felixzero/escrocs/README.md

# Repository of the E.S.C.Ro.C.S. team at the French robotics cup

We have participated in 2020, 2021 and 2022.

You can find here our codes, PCB and mechanical designs. We use Platform.io and VSCodium for coding, KiCAD for PCB CAD and either FreeCAD or TinkerCAD for mechanical design.
