felixzero/escrocs/CAD/electrical/accessory_board/README.md

# Accessory board

This PCB is a fairly large PCB meant for driving various types of actuators:
- up to 16 analog servos (typically MG-996 servos)
- up to 2 5V or 12V unipolar steppers
- up to 4 pumps or other 12V DC devices (2 x 500mA + 2 x 1A)

It does not require any firmware as it make use of NXP's I2C controller chips.
