felixzero/escrocs/CAD/electrical/main_board_v2/README.md

# Main board

This is the brain of our robots. It is based on a single ESP32 chip executing the strategy and interfacing with other boards.
