felixzero/escrocs/CAD/mechanical/servo_gears_info.md

# Dimensions d'engrenage

SG-90 : N=20 m=0.23mm
SG-90 : N=20 m=0.24mm (la version achetée sur eBay)

# Gros noir

N=25 m=0.23
