felixzero/escrocs/misc/ArUco/ArUcos_2022.docx

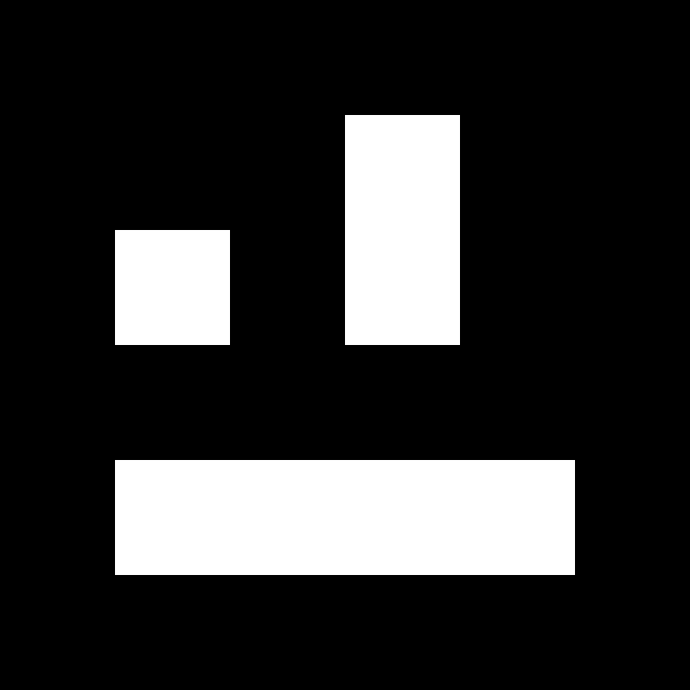
[picture p1: figure]

13 (bleu)

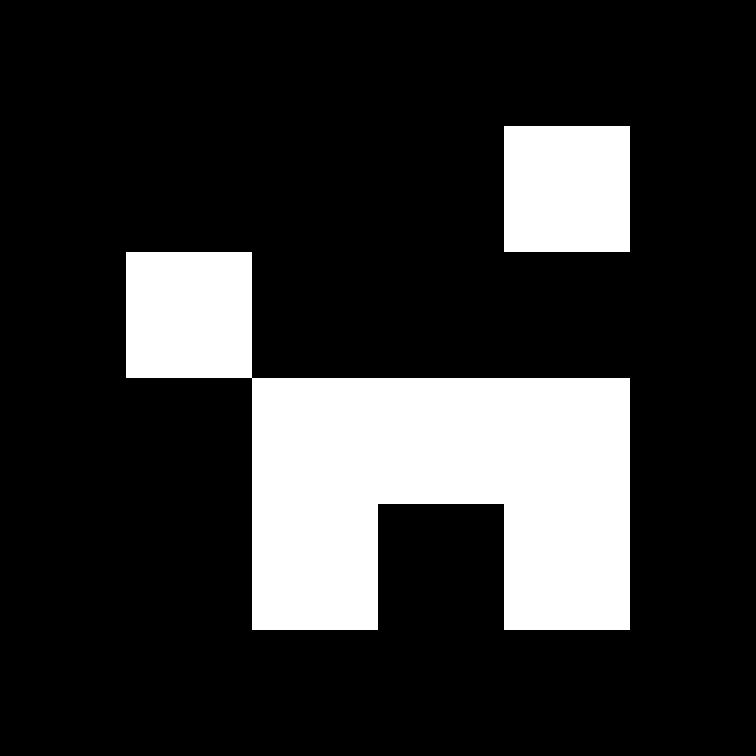
[picture p2: figure]

36 (vert)

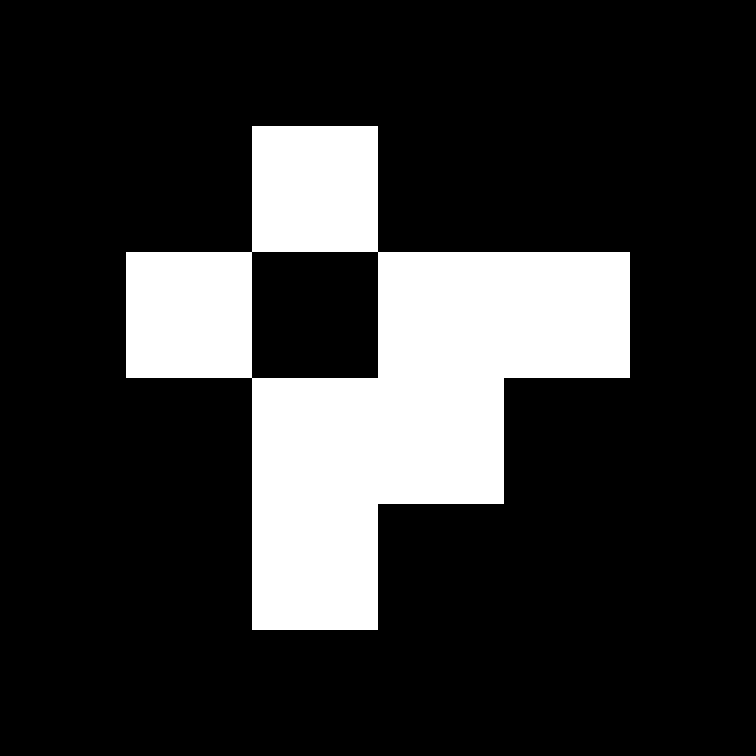
[picture p3: figure]

47 (rouge)
