felixzero/escrocs/misc/Poster 2022.pdf

Les robots des E.S.C.Ro.C.S.

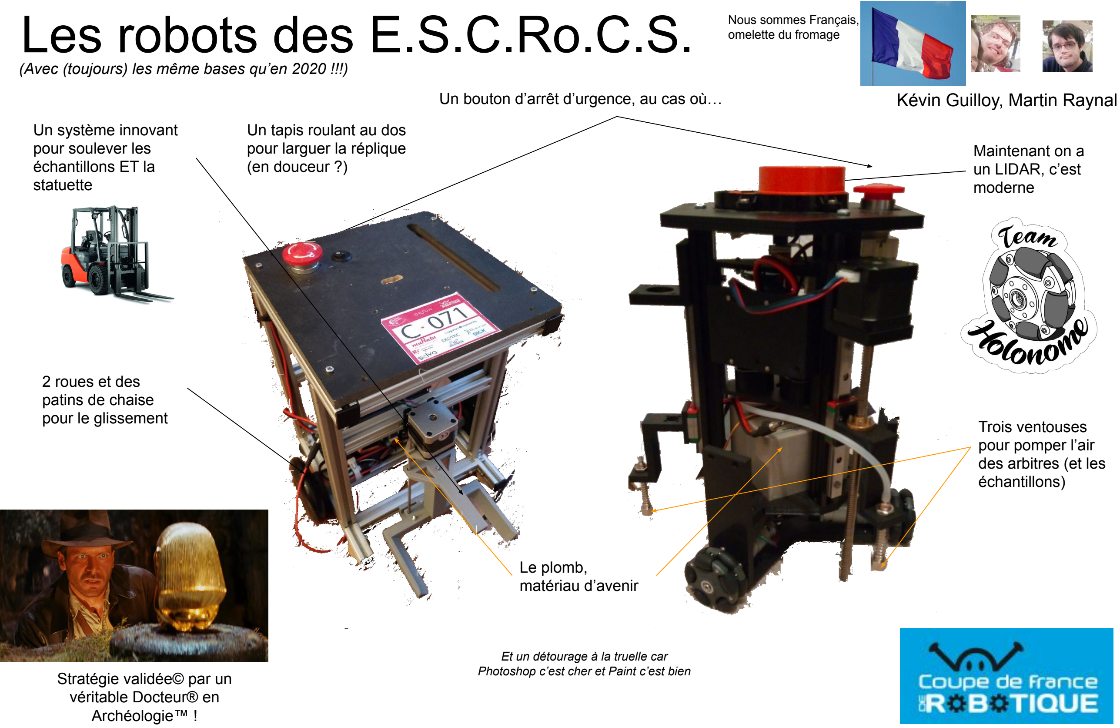
[picture p4: page 1]

2 roues et des
patins de chaise
pour le glissement

Le plomb,
matériau d’avenir

Un système innovant
pour soulever les
échantillons ET la
statuette

Un bouton d’arrêt d’urgence, au cas où…

Maintenant on a
un LIDAR, c’est
moderne

Nous sommes Français,
omelette du fromage

(Avec (toujours) les même bases qu’en 2020 !!!)

Kévin Guilloy, Martin Raynal

Stratégie validée© par un
véritable Docteur® en
Archéologie™ !

Trois ventouses
pour pomper l’air
des arbitres (et les
échantillons)

Un tapis roulant au dos
pour larguer la réplique
(en douceur ?)

Et un détourage à la truelle car Photoshop c’est cher et Paint c’est bien
