felixzero/escrocs/misc/remote_control/table.png

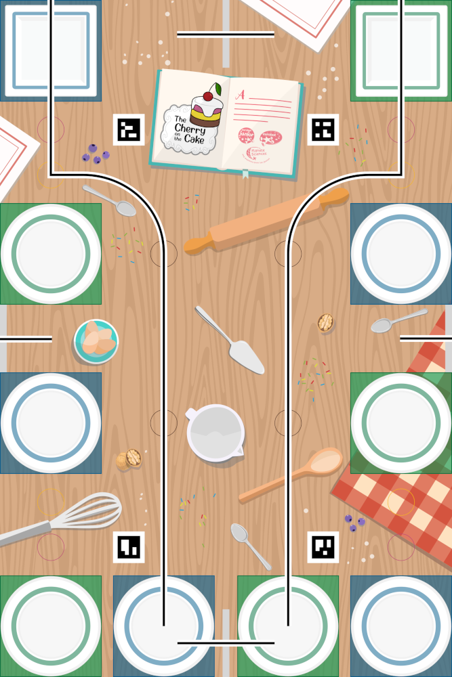
misc/remote_control/table.png
