felixzero/escrocs/CAD/electrical/motor_board_v3/bom.xlsx

Comment | Designator | Footprint | LCSC Part Number
100n capacitor | C1,C2,C4,C6,C8,C9,C10,C14,C15,C16,C20,C21,C22 | Capacitor_SMD:C_0603_1608Metric | C14663
10n 50V capacitor | C7,C13,C19 | Capacitor_SMD:C_0603_1608Metric | C57112
22p capacitor | C11,C17 | Capacitor_SMD:C_0603_1608Metric | C1653
470n capacitor | C12,C18,C24 | Capacitor_SMD:C_0603_1608Metric | C1623
SS54 | D5 | Diode_SMD:D_SMA | C22452
SMF30A | D6,D7 | Diode_SMD:D_SMF | C2990493
PSM712 | D9 | Package_TO_SOT_SMD:SOT-23 | C32677
2920L700SLPR | F1 | Fuse:Fuse_2920_7451Metric | C207093
BLM31PG330SZ1L | FB1 | Inductor_SMD:L_1206_3216Metric | C710521
GZ1608D601TF | FB2 | Inductor_SMD:L_0603_1608Metric | C1002
SI2301CDS-T1-GE3 | Q1 | Package_TO_SOT_SMD:SOT-23 | C10487
300 resistor | R1,R4,R6,R7 | Resistor_SMD:R_1206_3216Metric | C17887
220 resistor | R2,R3 | Resistor_SMD:R_0603_1608Metric | C22962
120 resistor | R5 | Resistor_SMD:R_0603_1608Metric | C22787
1,5M resistor | R9,R12,R15 | Resistor_SMD:R_0603_1608Metric | C4172
0,1 ohm resistor | R10,R11,R13,R14,R16,R17 | Resistor_SMD:R_1206_3216Metric | C25334
10k resistor | R18,R19 | Resistor_SMD:R_0603_1608Metric | C25804
Atmega328PB | U1 | Package_QFP:TQFP-32_7x7mm_P0.8mm | C132230
SN75176BDR | U2 | Package_SO:SOIC-8_3.9x4.9mm_P1.27mm | C7063
DRV8825 | U3,U4,U5 | Package_SO:HTSSOP-28-1EP_4.4x9.7mm_P0.65mm_EP2.85x5.4mm | C81582
SRV05-4 | U8,U6 | Package_TO_SOT_SMD:SOT-23-6 | C85364
16MHz crystal | Y1 | Crystal:Crystal_SMD_3225-4Pin_3.2x2.5mm | C13738
