felixzero/escrocs/CAD/electrical/ultrasonic_board/bom.xls

Comment | Designator | Footprint | LCSC Part Number
22pF capacitor | C1,C2 | 0603 | C1653
100nF capacitor | C4 | 0603 | C14663
LED | D1 | 0805 | C2296
10k resistor | R1 | 0603 | C25804
120r resistor | R2 | 0603 | C22787
470r resistor | R3 | 0603 | C23179
ATMegaX X=328,168 or 8 | U1 | TQFP-32 | C16190
8 MHz crystal | Y1 | HC49 | C12674
