felixzero/escrocs/CAD/electrical/stepper_board/fabrication_files/bom.xlsx

Comment | Designator | Footprint | LCSC Part Number
100n | C16,C19 | Capacitor_SMD:C_0805_2012Metric | C28233
22p | C20,C24 | Capacitor_SMD:C_0603_1608Metric | C1653
100n | C1,C7,C13,C15,C17,C25 | Capacitor_SMD:C_0603_1608Metric | C14663
1n | C2,C3,C8,C9,C26,C27 | Capacitor_SMD:C_0603_1608Metric | C1588
220n | C4,C5,C6,C10,C11,C12,C28,C29,C30 | Capacitor_SMD:C_0603_1608Metric | C21120
Status LED | D1,D2,D3 | LED_SMD:LED_0603_1608Metric | C72038
300o | R25,R26,R27 | Resistor_SMD:R_1206_3216Metric | C17887
10k | R2,R3,R6,R10,R11,R14,R28,R30,R31,R34 | Resistor_SMD:R_0603_1608Metric | C25804
47k | R1,R4,R9,R12,R29,R32 | Resistor_SMD:R_0603_1608Metric | C25819
33k | R5,R13,R33 | Resistor_SMD:R_0603_1608Metric | C4216
0.1 | R7,R8,R15,R16,R35,R36 | Resistor_SMD:R_1206_3216Metric | C25334
ATmega168PA-AU | U1 | Package_QFP:TQFP-32_7x7mm_P0.8mm | C8728
DRV8811 | U2,U4,U5 | Package_SO:HTSSOP-28-1EP_4.4x9.7mm_P0.65mm_EP2.85x5.4mm_ThermalVias | C133174
ULN2003 | U3 | Package_SO:SO-16_3.9x9.9mm_P1.27mm | C7512
Crystal | Y1 | Crystal:Crystal_SMD_HC49-SD | C12674
