felixzero/escrocs/CAD/mechanical/2022_robot1_square/batterie_elec/batterie_elec.FCStd

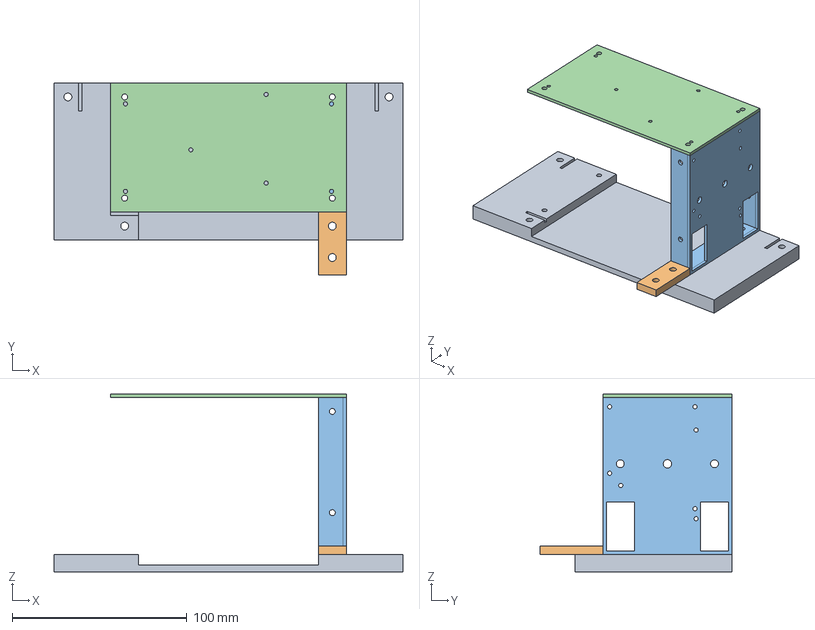
[picture p6: CAD file, 2021-10-28]
CAD/mechanical/2022_robot1_square/batterie_elec/batterie_elec.FCStd
200.0 x 110.0 x 102.0 mm
Fond
PatteFixation
PlaqueLaterale
PlaqueDessus
