felixzero/escrocs/CAD/mechanical/2022_robot1_square/mat_balise_robot_carre/mat_balise_robot_carre.FCStd

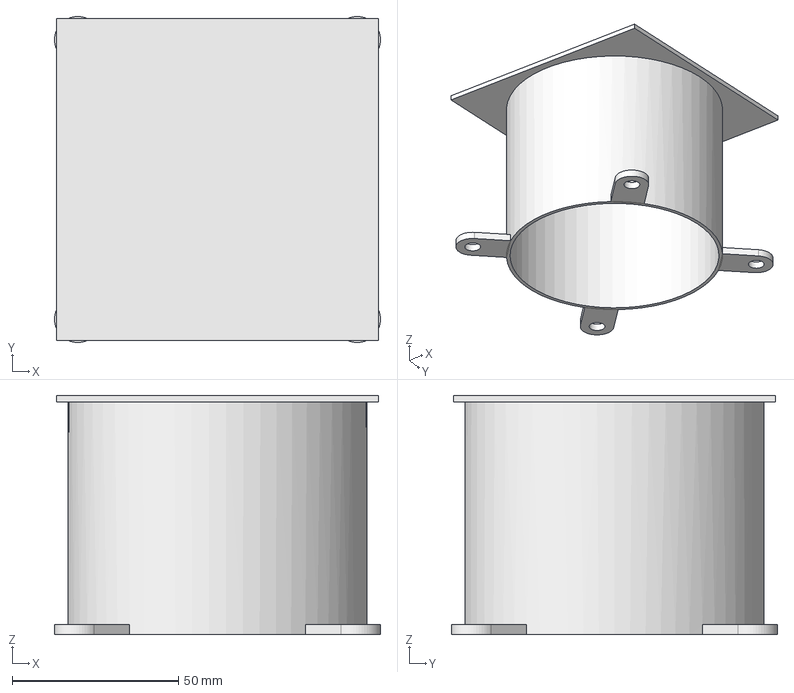
[picture p7: CAD file, 2022-05-18]
CAD/mechanical/2022_robot1_square/mat_balise_robot_carre/mat_balise_robot_carre.FCStd
98.1 x 98.1 x 72.0 mm
