felixzero/escrocs/CAD/mechanical/2022_robot1_square/patin/patin_thick.FCStd

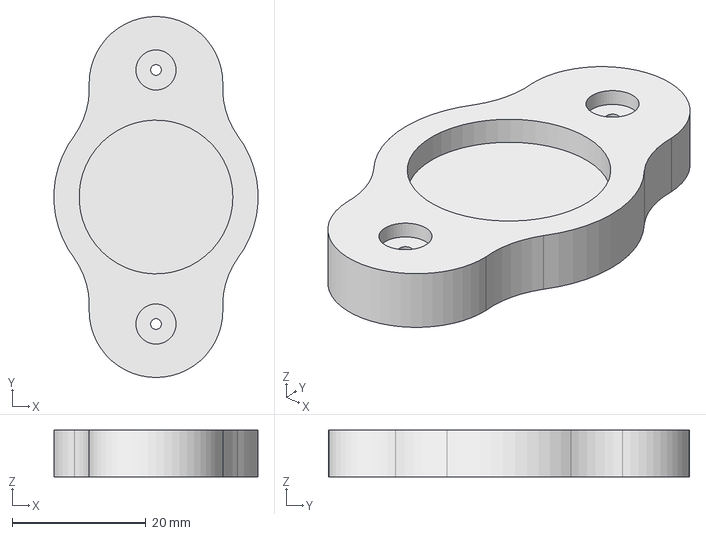
[picture p8: CAD file, 2021-07-31]
CAD/mechanical/2022_robot1_square/patin/patin_thick.FCStd
30.5 x 54.0 x 7.00 mm
