felixzero/escrocs/CAD/mechanical/2022_robot1_square/pince-statuette/Robot_2022_support_broche.stl

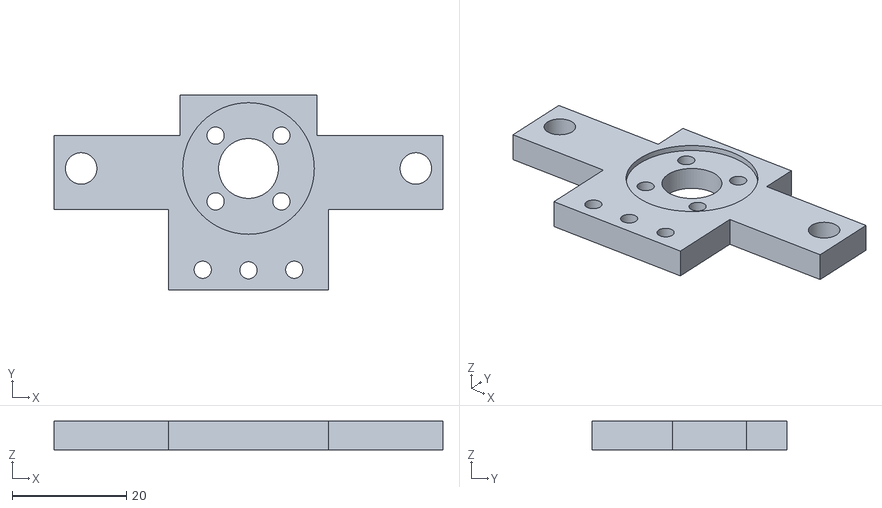
[picture p9: CAD file, 2022-05-23]
CAD/mechanical/2022_robot1_square/pince-statuette/Robot_2022_support_broche.stl
68.0 x 34.0 x 5.00
