felixzero/escrocs/CAD/mechanical/2022_robot1_square/score-plate/score-plate.FCStd

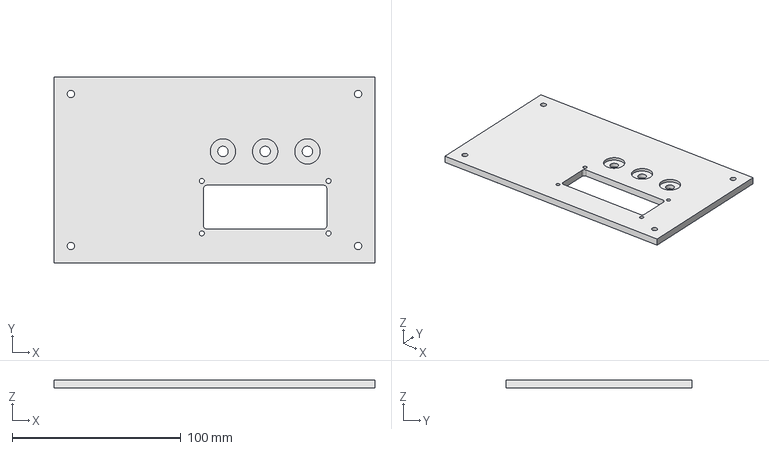
[picture p10: CAD file, 2020-11-22]
CAD/mechanical/2022_robot1_square/score-plate/score-plate.FCStd
190.0 x 110.0 x 5.00 mm
