felixzero/escrocs/CAD/mechanical/2022_robot1_square/statuette/Statuette_EUROBOT2022.stl

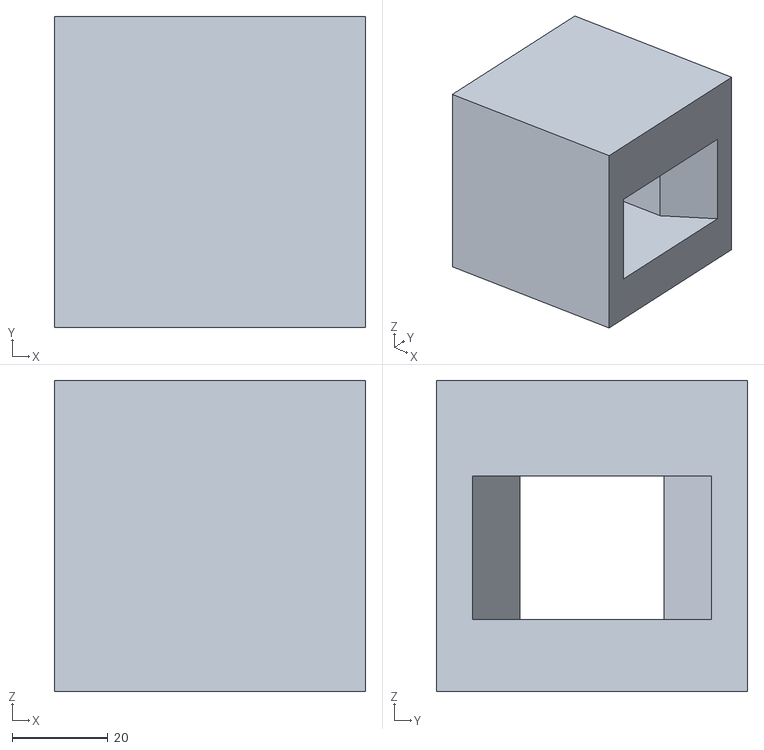
[picture p11: CAD file, 2022-05-23]
CAD/mechanical/2022_robot1_square/statuette/Statuette_EUROBOT2022.stl
65.0 x 65.0 x 65.0
