felixzero/escrocs/CAD/mechanical/2022_robot1_square/support-moteur/support-moteur-long.FCStd

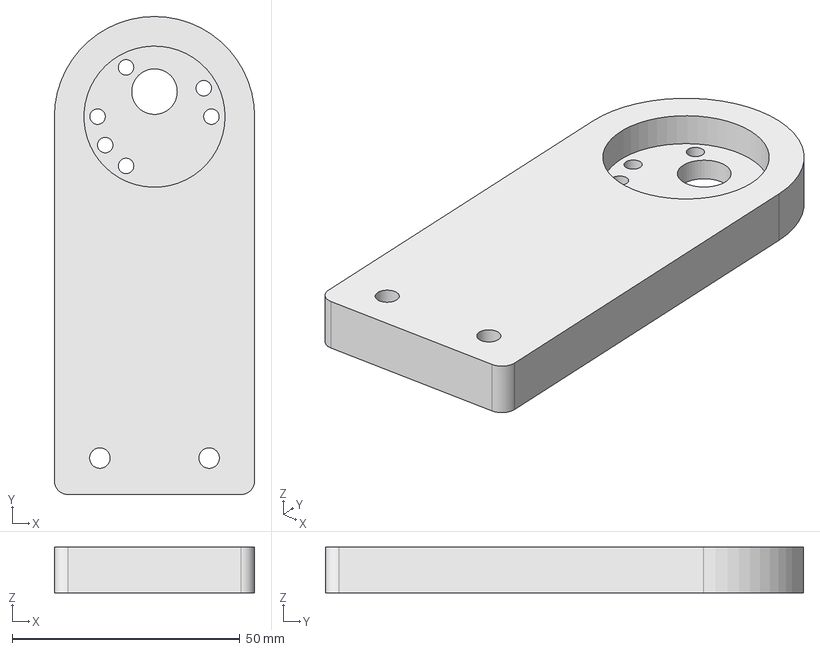
[picture p12: CAD file, 2021-06-20]
CAD/mechanical/2022_robot1_square/support-moteur/support-moteur-long.FCStd
44.0 x 105.0 x 10.0 mm
