felixzero/escrocs/CAD/mechanical/2022_robot1_square/T-joints/T-Slot_H3.stl

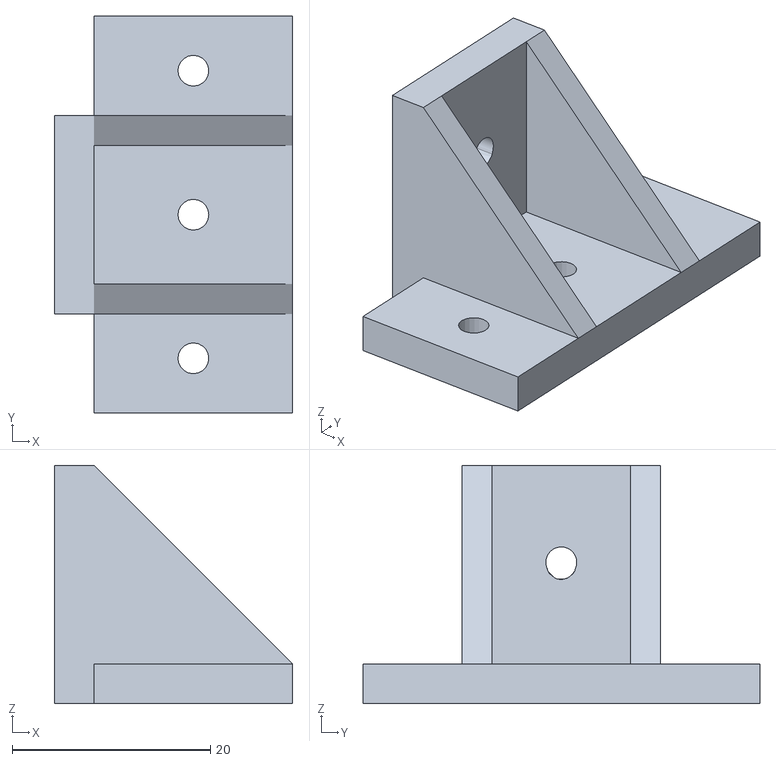
[picture p13: CAD file, 2021-06-06]
CAD/mechanical/2022_robot1_square/T-joints/T-Slot_H3.stl
24.0 x 40.0 x 24.0
