felixzero/escrocs/CAD/mechanical/2022_robot2_triangle/base_roulante/base_roulante_v2.FCStd

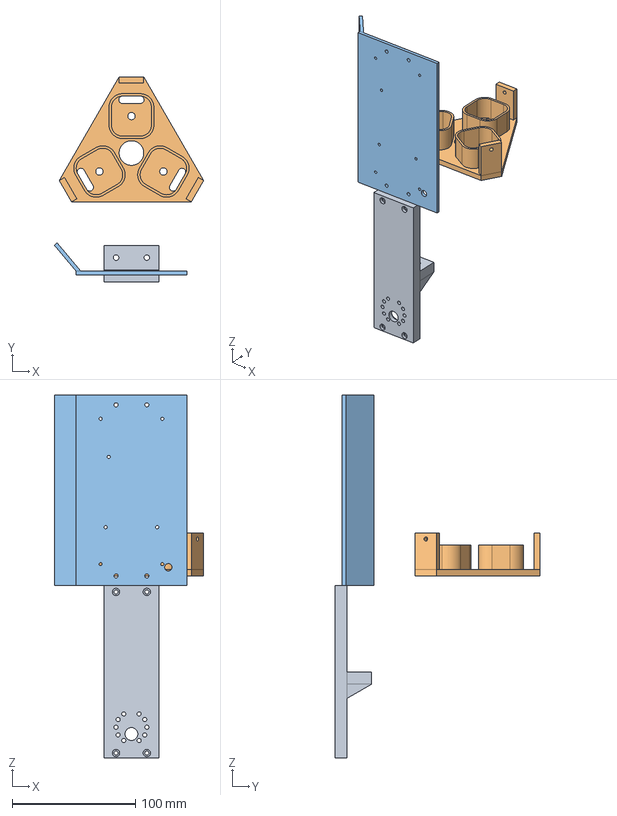
[picture p14: CAD file, 2022-05-18]
CAD/mechanical/2022_robot2_triangle/base_roulante/base_roulante_v2.FCStd
121.4 x 167.0 x 295.0 mm
SupportMoteur
SupportPompe
CoteAutocollant
