felixzero/escrocs/CAD/mechanical/2022_robot2_triangle/rail_pompe/rail_pompe.FCStd

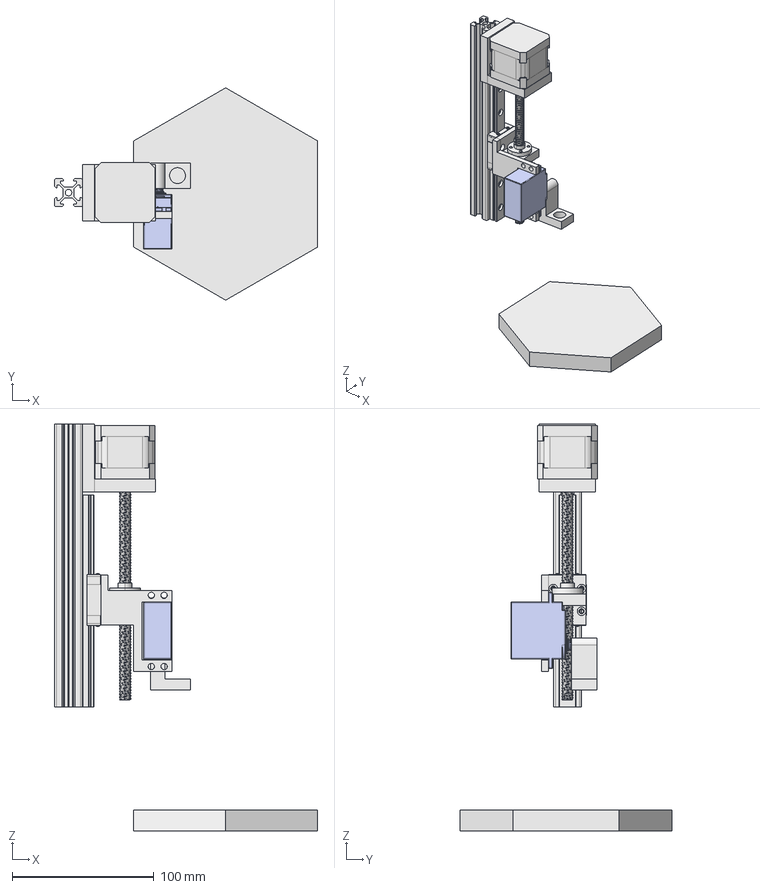
[picture p15: CAD file, 2022-05-09]
CAD/mechanical/2022_robot2_triangle/rail_pompe/rail_pompe.FCStd
186.0 x 150.0 x 287.5 mm
ProfileAlu
RailGlissiere
Echantillon
Stepper001
TravelingNut
SupportStepper
Servo MG996R
SupportGlissiereArticulee
SupportPompeArticulee
