felixzero/escrocs/CAD/mechanical/2022_robot2_triangle/support-mat-balise/support-mat-balise.FCStd

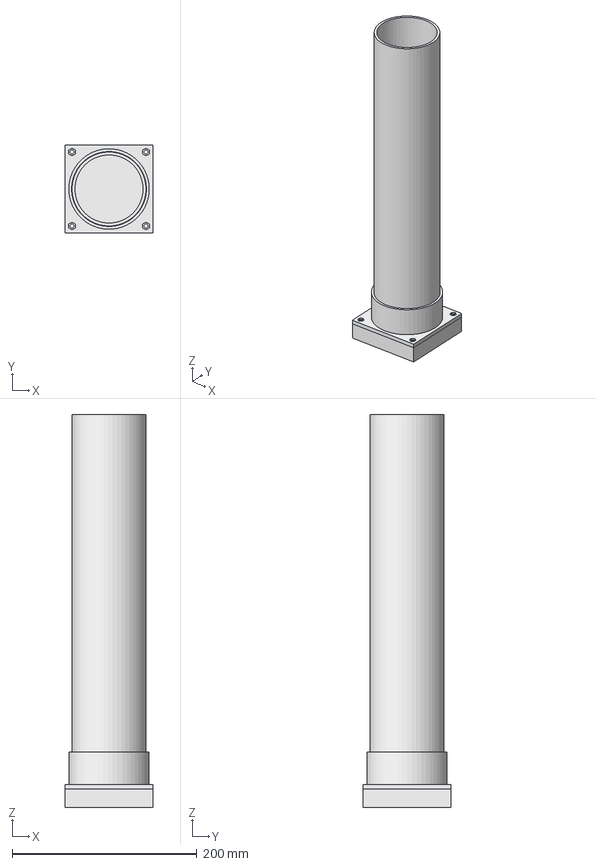
[picture p16: CAD file, 2022-02-14]
CAD/mechanical/2022_robot2_triangle/support-mat-balise/support-mat-balise.FCStd
95.0 x 95.0 x 425.0 mm
Plaque de base
Plaque de support tuyau
Tuyau
