felixzero/escrocs/CAD/mechanical/2024_base_roulante/base_roulante_2024-Pare-choc.amf

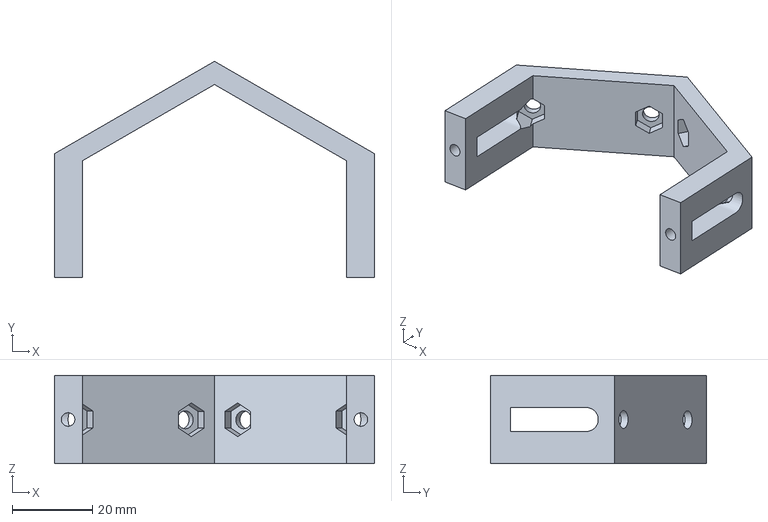
[picture p17: CAD file, 2023-06-20]
CAD/mechanical/2024_base_roulante/base_roulante_2024-Pare-choc.amf
80.0 x 54.1 x 22.0 mm
