felixzero/escrocs/CAD/mechanical/amf/support-us-USRing.amf

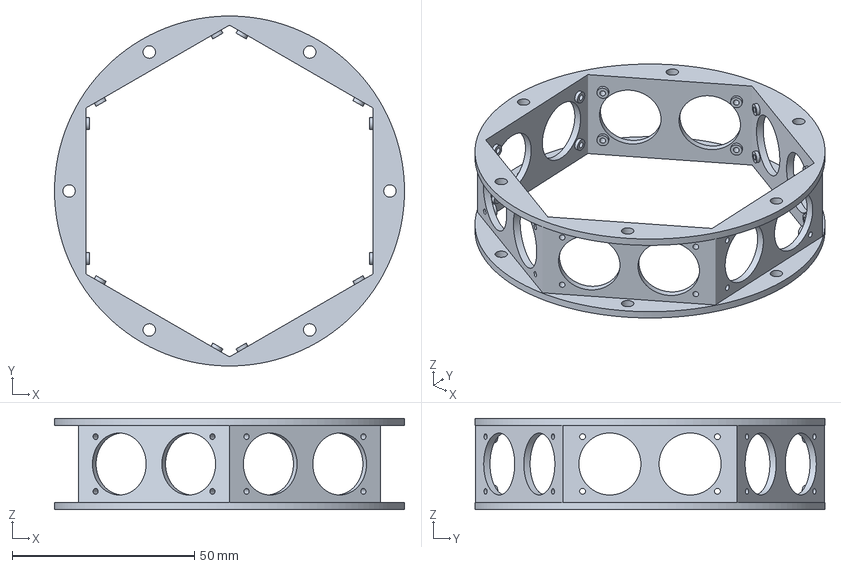
[picture p18: CAD file, 2023-05-22]
CAD/mechanical/amf/support-us-USRing.amf
96.0 x 96.0 x 25.0 mm
