felixzero/escrocs/CAD/mechanical/support-us.FCStd

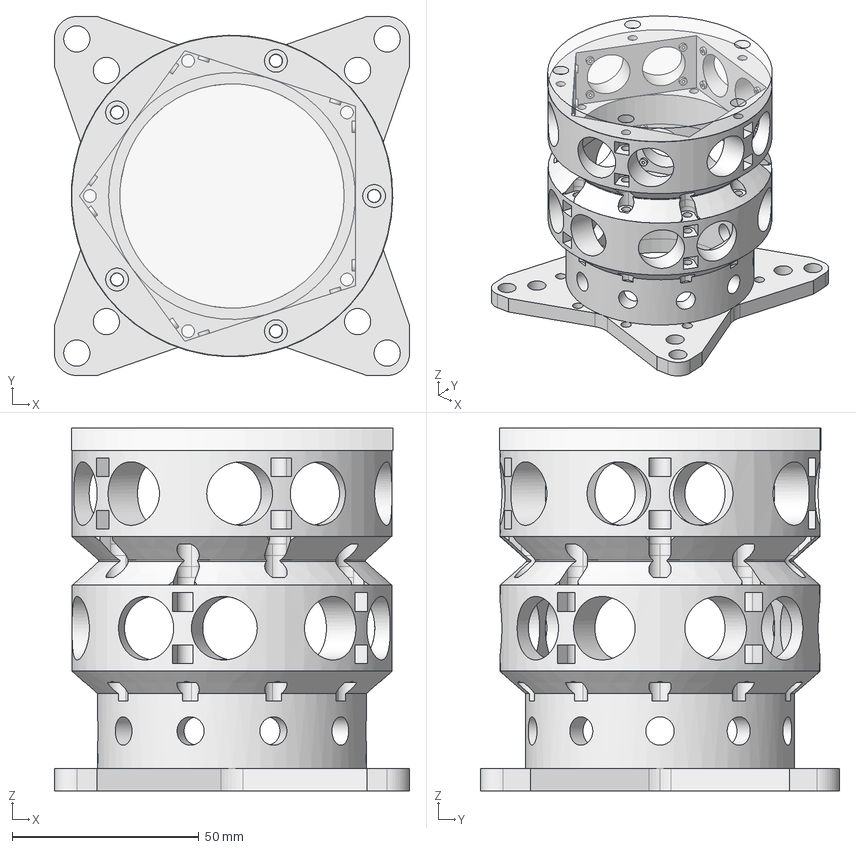
[picture p19: CAD file, 2023-05-22]
CAD/mechanical/support-us.FCStd
95.0 x 96.0 x 97.0 mm
US Ring Pentagon x 2
LED Support Pentagon
Support PCB Pentagon
Toit
