felixzero/escrocs/CAD/mechanical/trigger/trigger-Clef.amf

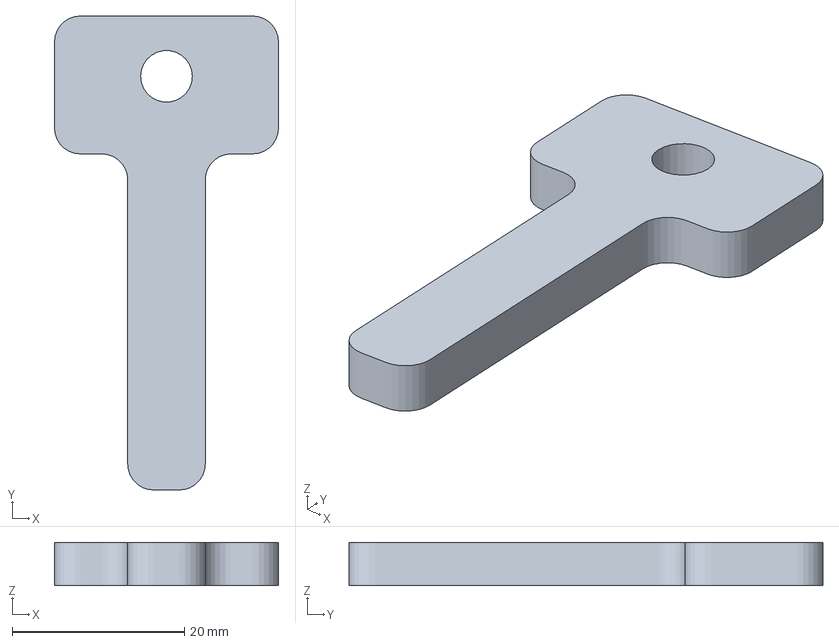
[picture p20: CAD file, 2023-05-22]
CAD/mechanical/trigger/trigger-Clef.amf
26.0 x 55.0 x 5.00 mm
