felixzero/escrocs/CAD/mechanical/2022_robot1_square/patin/patin.FCStd

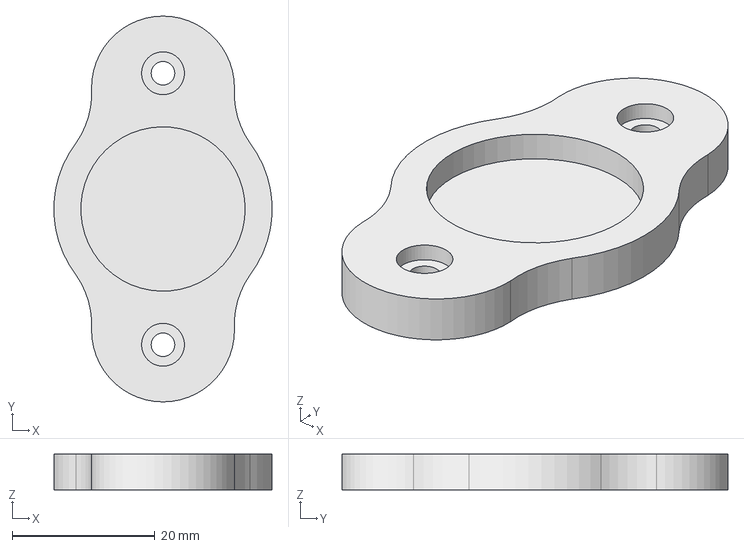
[picture p21: CAD file, 2021-01-08]
CAD/mechanical/2022_robot1_square/patin/patin.FCStd
30.5 x 54.0 x 5.00 mm
