felixzero/escrocs/CAD/mechanical/2022_robot1_square/pince-statuette/Robot_2022_broche-v2.stl

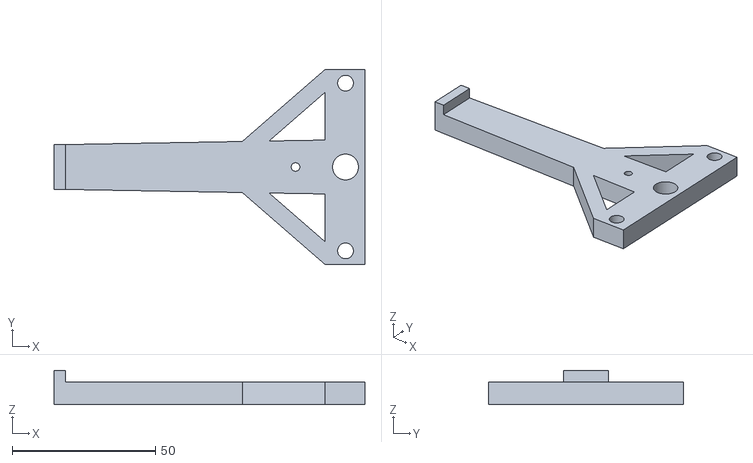
[picture p22: CAD file, 2022-05-23]
CAD/mechanical/2022_robot1_square/pince-statuette/Robot_2022_broche-v2.stl
108.5 x 68.0 x 12.0
