felixzero/escrocs/CAD/mechanical/2022_robot1_square/support-moteur/support-moteur-v2.FCStd

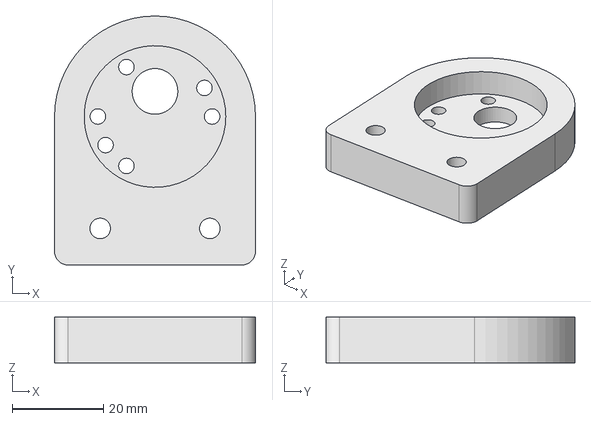
[picture p23: CAD file, 2021-01-08]
CAD/mechanical/2022_robot1_square/support-moteur/support-moteur-v2.FCStd
44.0 x 54.5 x 10.0 mm
