felixzero/escrocs/CAD/mechanical/2022_robot1_square/T-joints/T-Slot_4.stl

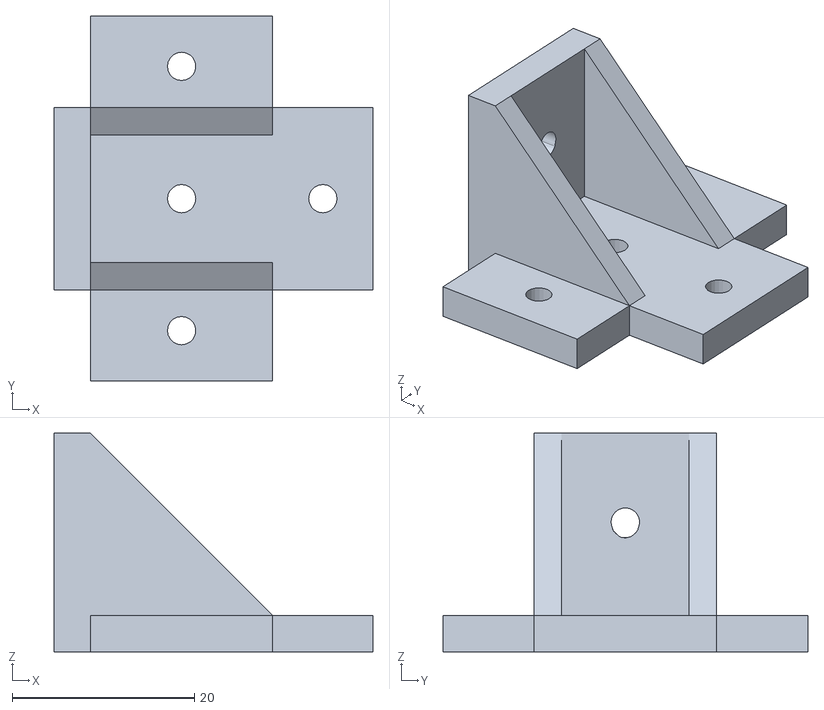
[picture p24: CAD file, 2021-06-06]
CAD/mechanical/2022_robot1_square/T-joints/T-Slot_4.stl
35.0 x 40.0 x 24.0
