felixzero/escrocs/CAD/mechanical/2024_base_roulante/base_roulante_2024-Base.amf

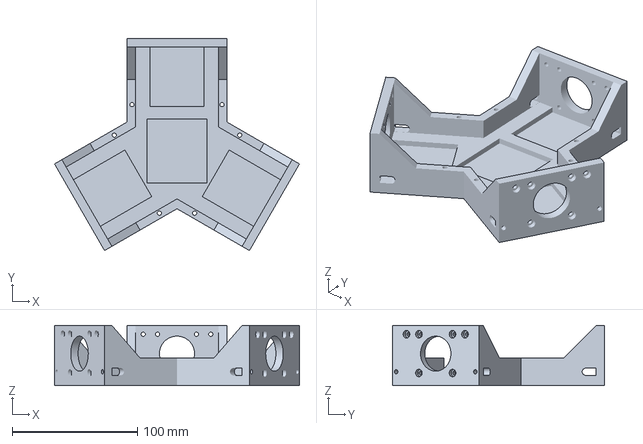
[picture p25: CAD file, 2023-06-20]
CAD/mechanical/2024_base_roulante/base_roulante_2024-Base.amf
195.9 x 169.6 x 48.0 mm
