felixzero/escrocs/CAD/mechanical/amf/support-us-PCBRing.amf

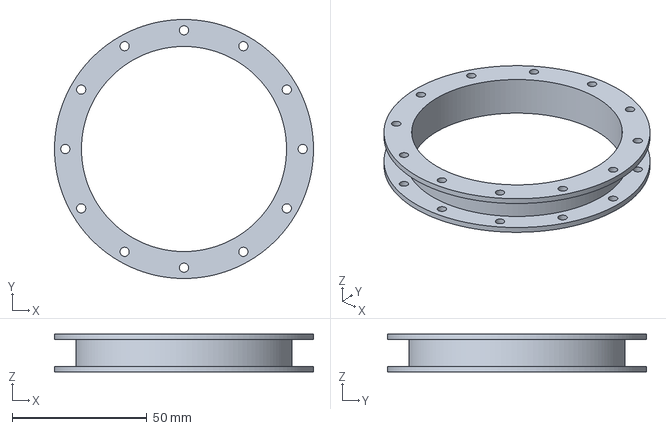
[picture p26: CAD file, 2023-05-22]
CAD/mechanical/amf/support-us-PCBRing.amf
96.0 x 96.0 x 14.0 mm
