felixzero/escrocs/CAD/mechanical/robot_triangle.FCStd

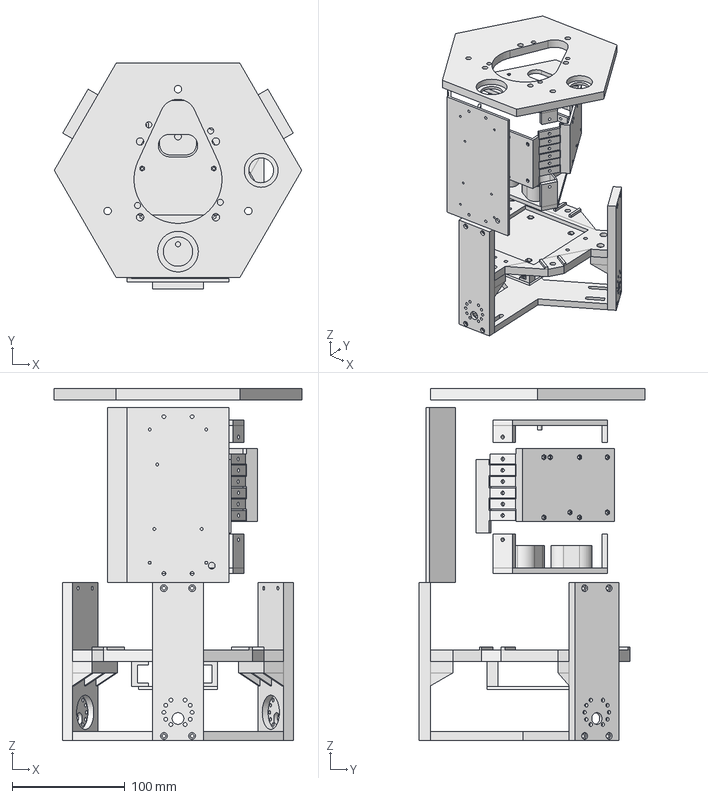
[picture p27: CAD file, 2023-03-11]
CAD/mechanical/robot_triangle.FCStd
219.4 x 200.0 x 312.0 mm
TriangleBatterie
SupportCarteMoteur
EquerreCarteMoteur x 4
SupportMoteur x 3
RenfortBas
SupportPompe
SupportCarteMere x 2
SupportLidar
SupportCarteLidar
CoteAutocollant
