felixzero/escrocs/CAD/mechanical/trigger/trigger.FCStd

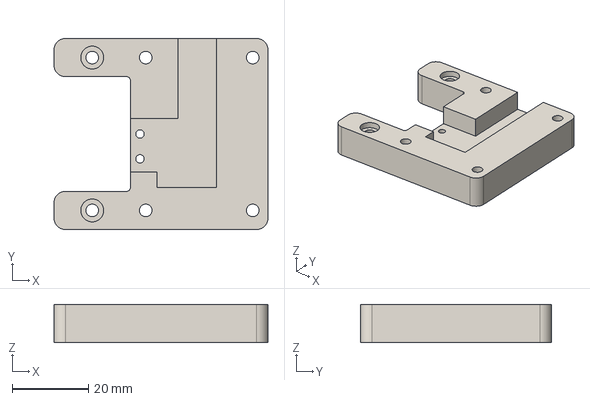
[picture p28: CAD file, 2020-11-17]
CAD/mechanical/trigger/trigger.FCStd
56.0 x 50.0 x 10.0 mm
