felixzero/escrocs/CAD/mechanical/2022_robot1_square/pince-statuette/bras_vitrine.stl

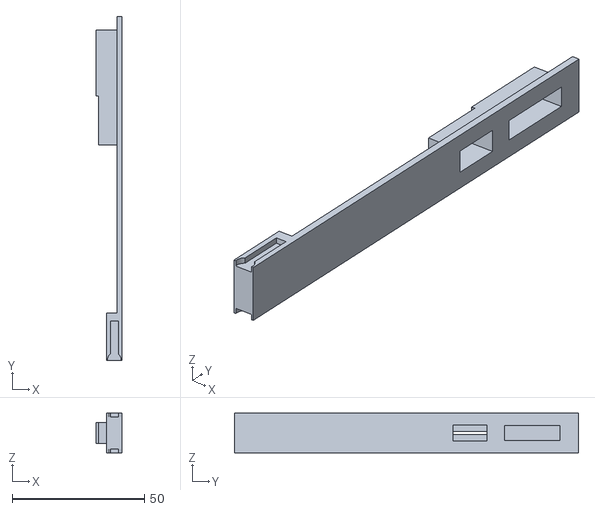
[picture p29: CAD file, 2022-05-23]
CAD/mechanical/2022_robot1_square/pince-statuette/bras_vitrine.stl
10.0 x 130.0 x 15.0
