felixzero/escrocs/CAD/mechanical/2022_robot1_square/T-joints/T-Junction.stl

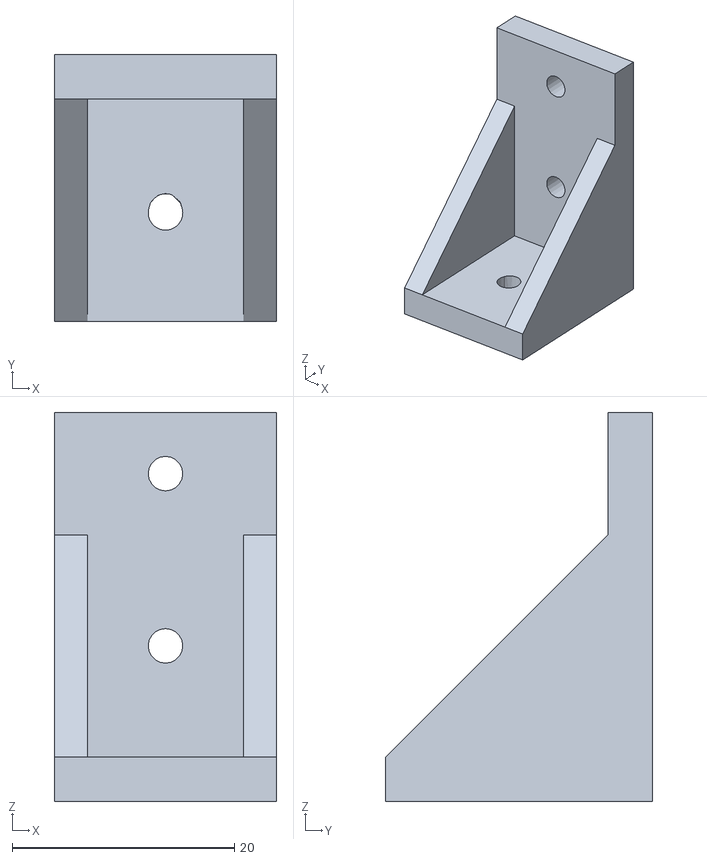
[picture p30: CAD file, 2021-06-06]
CAD/mechanical/2022_robot1_square/T-joints/T-Junction.stl
20.0 x 24.0 x 35.0
