felixzero/escrocs/CAD/mechanical/2024_base_roulante/base_roulante_2024-Carter base roulante.amf

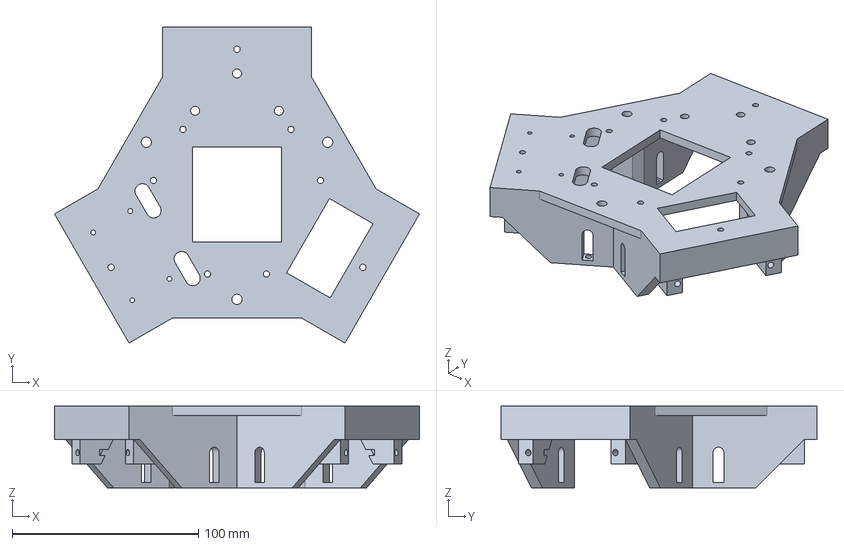
[picture p31: CAD file, 2023-06-20]
CAD/mechanical/2024_base_roulante/base_roulante_2024-Carter base roulante.amf
195.9 x 169.6 x 44.0 mm
