felixzero/escrocs/CAD/mechanical/amf/support-us-Support PCB Pentagon.amf

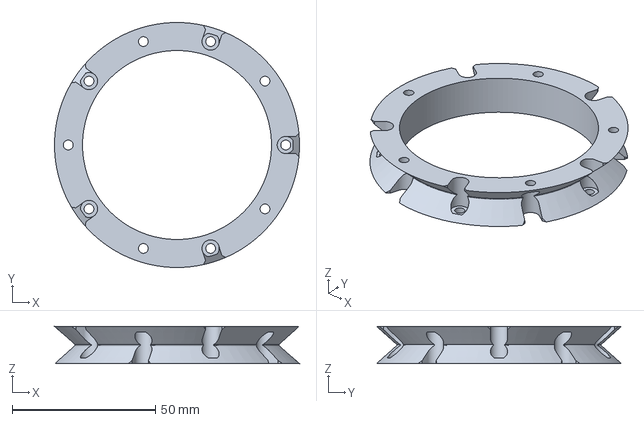
[picture p32: CAD file, 2023-05-22]
CAD/mechanical/amf/support-us-Support PCB Pentagon.amf
85.6 x 85.6 x 13.0 mm
