felixzero/escrocs/CAD/mechanical/2022_robot1_square/pince-statuette/Robot_2022_broche.stl

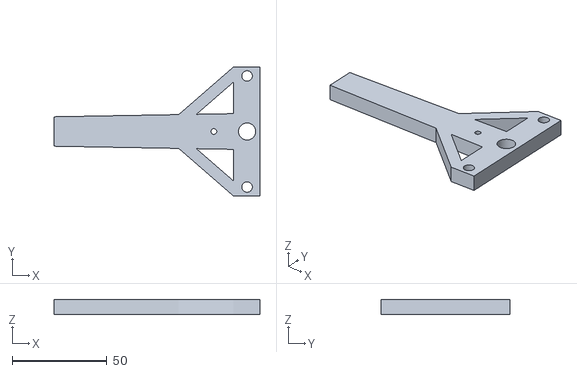
[picture p33: CAD file, 2022-05-23]
CAD/mechanical/2022_robot1_square/pince-statuette/Robot_2022_broche.stl
108.5 x 68.0 x 8.00
