felixzero/escrocs/CAD/mechanical/2022_robot1_square/T-joints/T-SlotAngle-Brackets-M3.stl

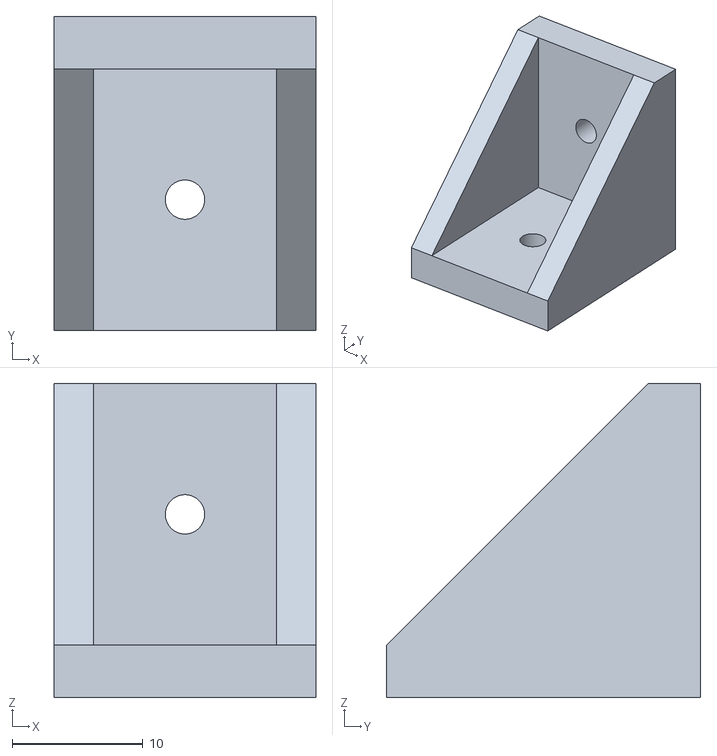
[picture p34: CAD file, 2021-06-06]
CAD/mechanical/2022_robot1_square/T-joints/T-SlotAngle-Brackets-M3.stl
20.0 x 24.0 x 24.0
