felixzero/escrocs/CAD/mechanical/2024_base_roulante/base_roulante_2024-Common.amf

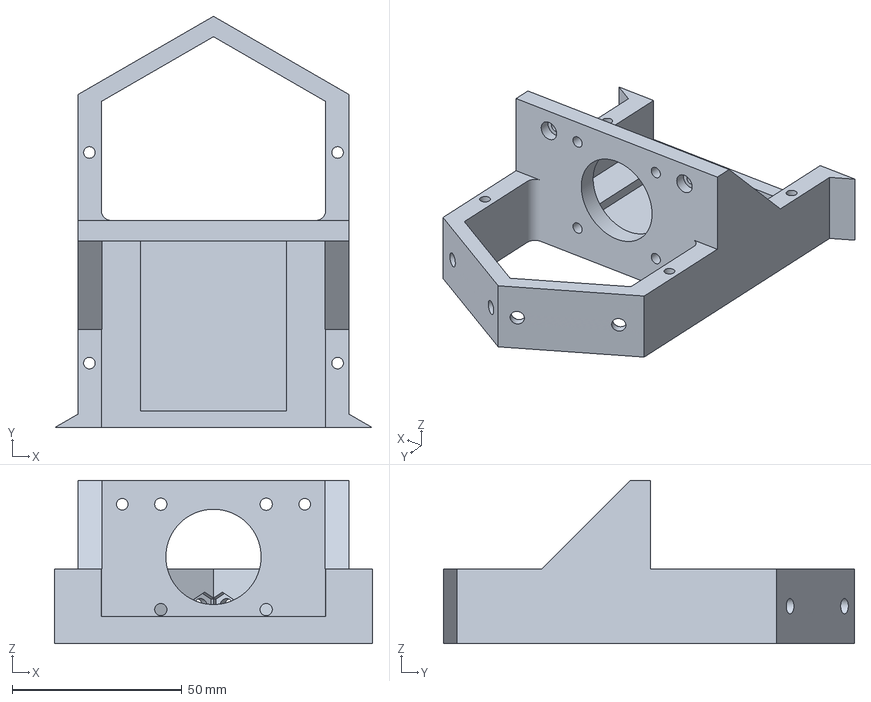
[picture p35: CAD file, 2023-06-20]
CAD/mechanical/2024_base_roulante/base_roulante_2024-Common.amf
93.5 x 121.0 x 48.0 mm
