felixzero/escrocs/CAD/mechanical/amf/support-us-US Ring Pentagon.amf

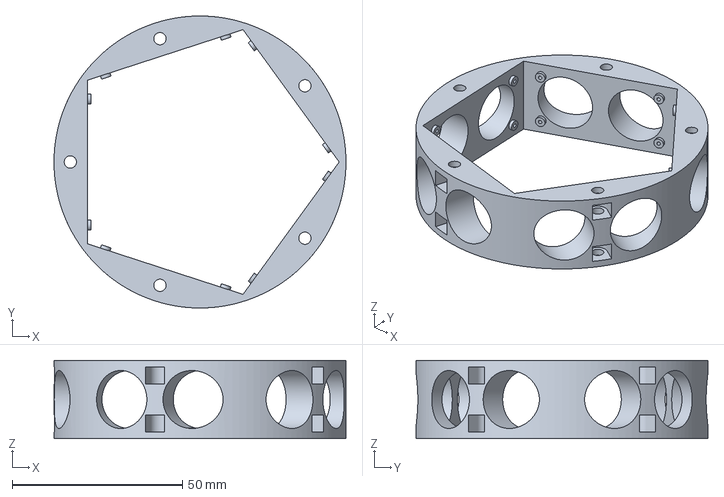
[picture p36: CAD file, 2023-05-22]
CAD/mechanical/amf/support-us-US Ring Pentagon.amf
85.7 x 85.7 x 23.0 mm
