felixzero/escrocs/CAD/mechanical/2022_robot1_square/pince-statuette/support_bras_vitrine.stl

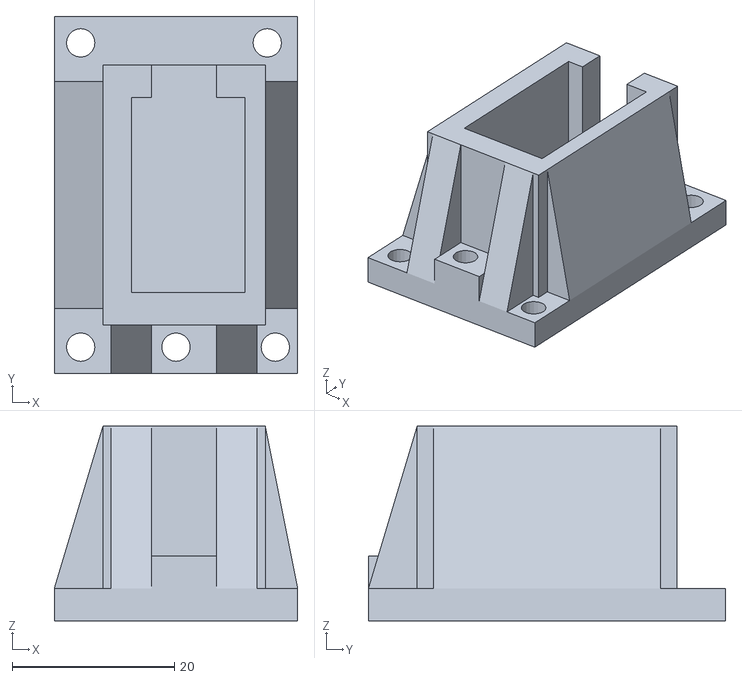
[picture p37: CAD file, 2022-05-23]
CAD/mechanical/2022_robot1_square/pince-statuette/support_bras_vitrine.stl
30.0 x 44.0 x 24.0
