felixzero/escrocs/CAD/mechanical/2024_base_roulante/base_roulante_2024.FCStd

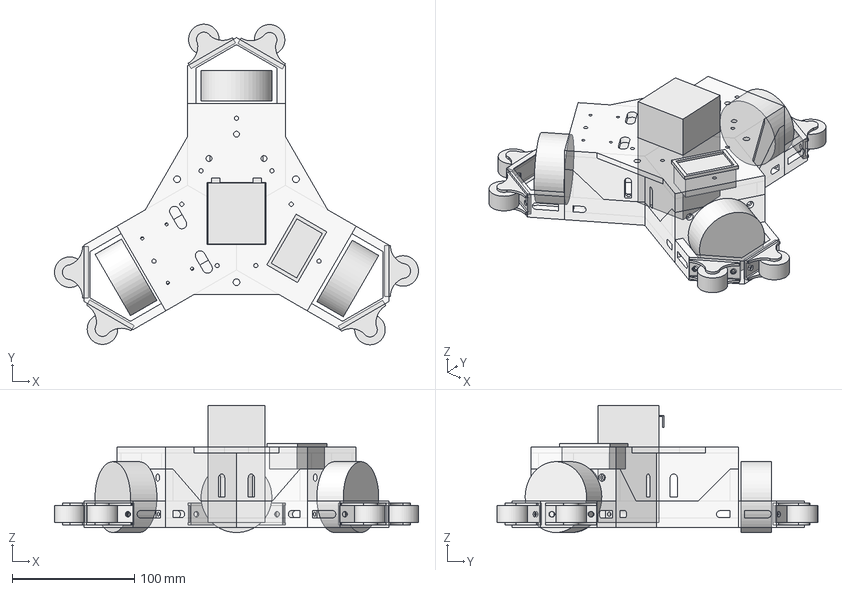
[picture p38: CAD file, 2023-06-20]
CAD/mechanical/2024_base_roulante/base_roulante_2024.FCStd
298.0 x 262.5 x 104.0 mm
Roue x 3
Roulette x 6
Pare-choc x 3
Base
Batterie
Carter base roulante
Indicateur de niveau de batterie
