felixzero/escrocs/CAD/mechanical/amf/support-us-LED Support Pentagon.amf

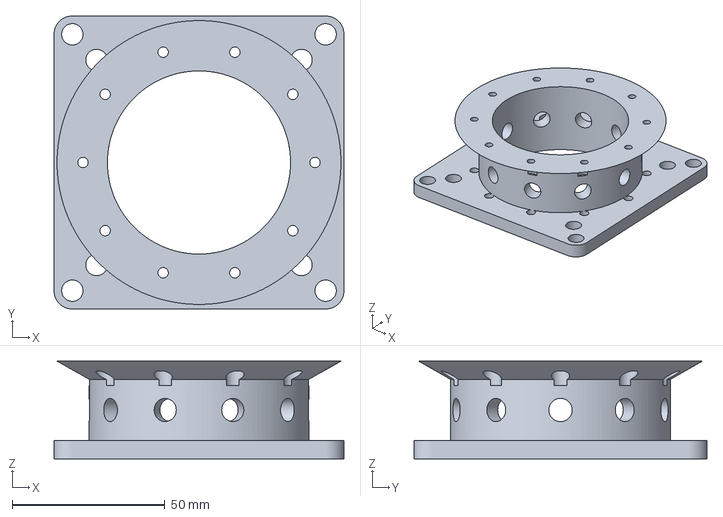
[picture p39: CAD file, 2023-05-22]
CAD/mechanical/amf/support-us-LED Support Pentagon.amf
95.0 x 96.0 x 32.0 mm
