felixzero/escrocs/CAD/mechanical/2022_robot1_square/pince-statuette/bras_vitrine_v2.stl

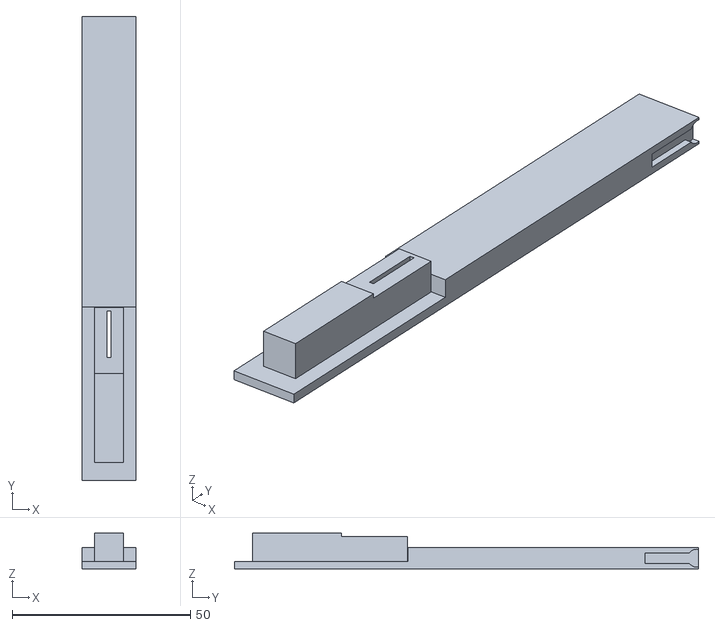
[picture p40: CAD file, 2022-05-23]
CAD/mechanical/2022_robot1_square/pince-statuette/bras_vitrine_v2.stl
15.0 x 130.0 x 10.0
