felixzero/escrocs/CAD/mechanical/2024_base_roulante/base_roulante_2024-Plaque de base roulante.amf

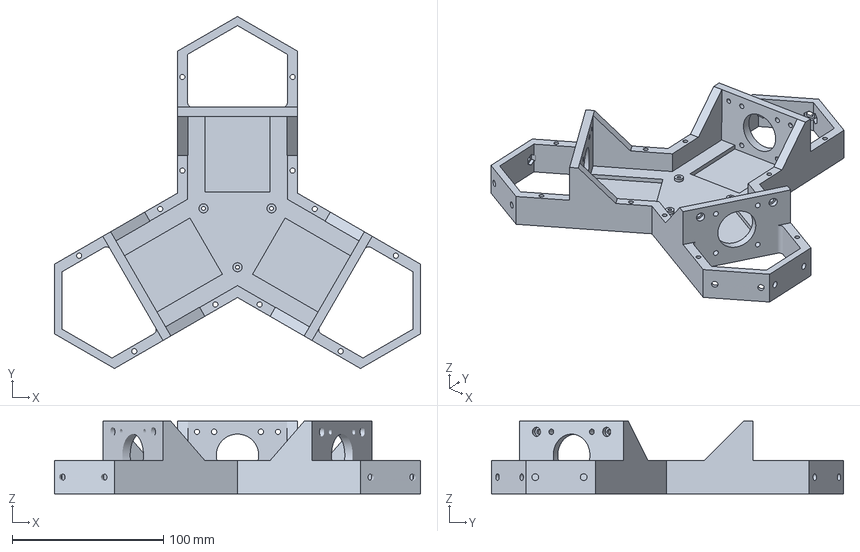
[picture p41: CAD file, 2023-06-20]
CAD/mechanical/2024_base_roulante/base_roulante_2024-Plaque de base roulante.amf
242.5 x 233.0 x 48.0 mm
