felixzero/escrocs/CAD/mechanical/amf/support-us-Toit.amf

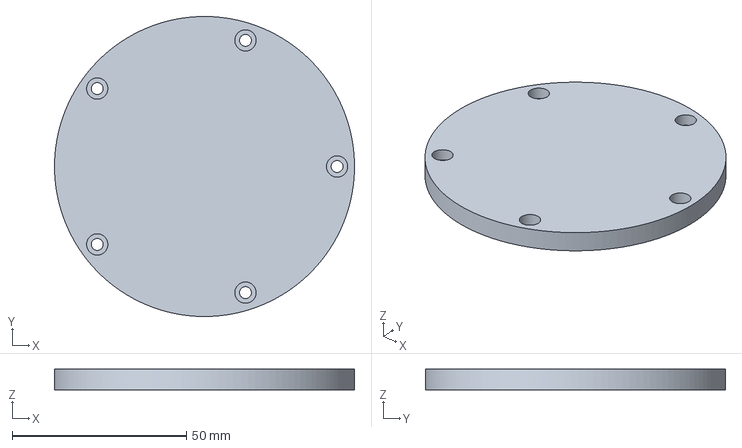
[picture p42: CAD file, 2023-05-22]
CAD/mechanical/amf/support-us-Toit.amf
86.0 x 86.0 x 6.00 mm
