felixzero/escrocs/CAD/mechanical/2022_robot1_square/pince-statuette/Robot_2022_support_pince_V.stl

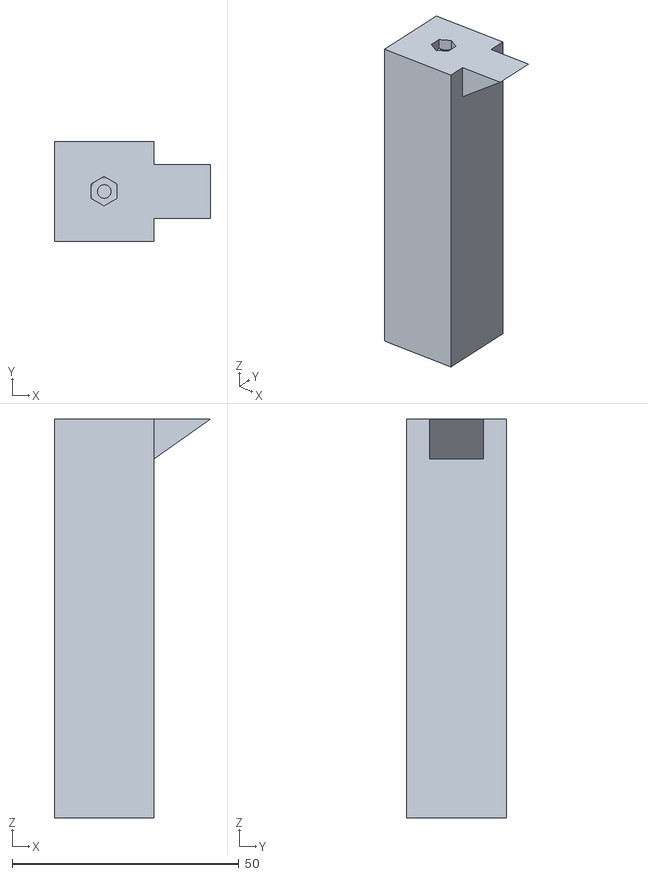
[picture p43: CAD file, 2022-05-23]
CAD/mechanical/2022_robot1_square/pince-statuette/Robot_2022_support_pince_V.stl
34.4 x 22.0 x 88.0
