felixzero/escrocs/CAD/mechanical/2022_robot1_square/pince-statuette/Robot_2022_pince_support_Bas.stl

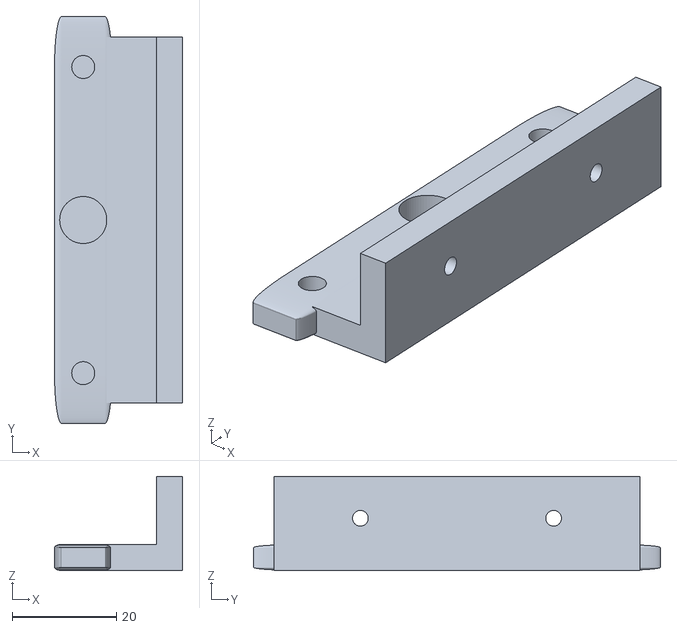
[picture p44: CAD file, 2022-05-23]
CAD/mechanical/2022_robot1_square/pince-statuette/Robot_2022_pince_support_Bas.stl
24.5 x 77.9 x 18.0
