felixzero/escrocs/CAD/mechanical/2022_robot1_square/pince-statuette/Robot_2022_pince_support_haut.stl

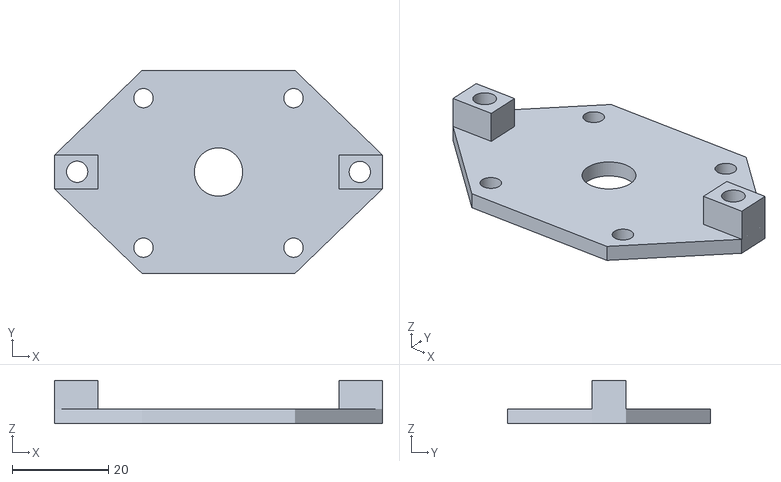
[picture p45: CAD file, 2022-05-23]
CAD/mechanical/2022_robot1_square/pince-statuette/Robot_2022_pince_support_haut.stl
68.0 x 42.0 x 9.00
