felixzero/escrocs/CAD/mechanical/2022_robot1_square/pince-statuette/Robot_2022_pince_v2.stl

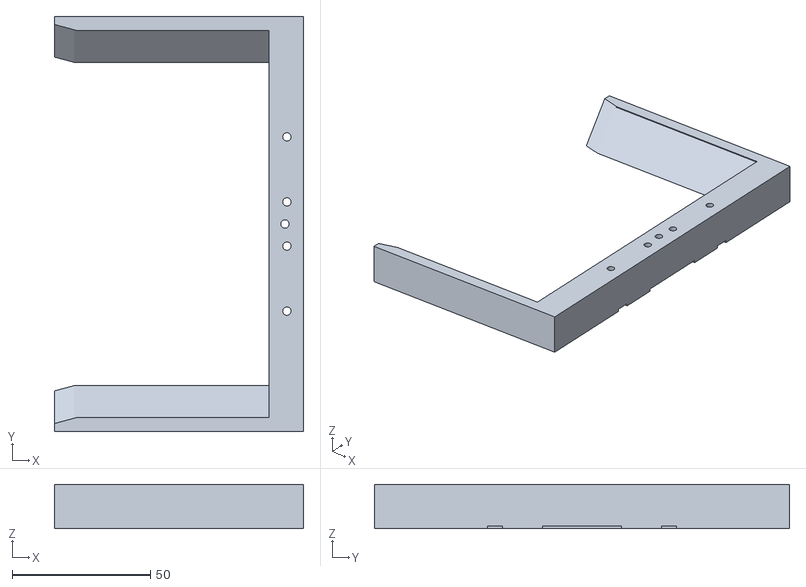
[picture p46: CAD file, 2022-05-23]
CAD/mechanical/2022_robot1_square/pince-statuette/Robot_2022_pince_v2.stl
90.0 x 150.0 x 16.0
