felixzero/escrocs/(list of files, cad)

Other CAD files:
CAD/mechanical/support-us-LED Support Pentagon.amf
CAD/mechanical/support-us-Support PCB Pentagon.amf
CAD/mechanical/support-us-Toit.amf
CAD/mechanical/support-us-US Ring Pentagon.amf
