felixzero/escrocs/CAD/electrical/main_board_v2/main_board.kicad_pcb

## KiCad design CAD/electrical/main_board_v2/main_board.kicad_pcb (2023-11-19)

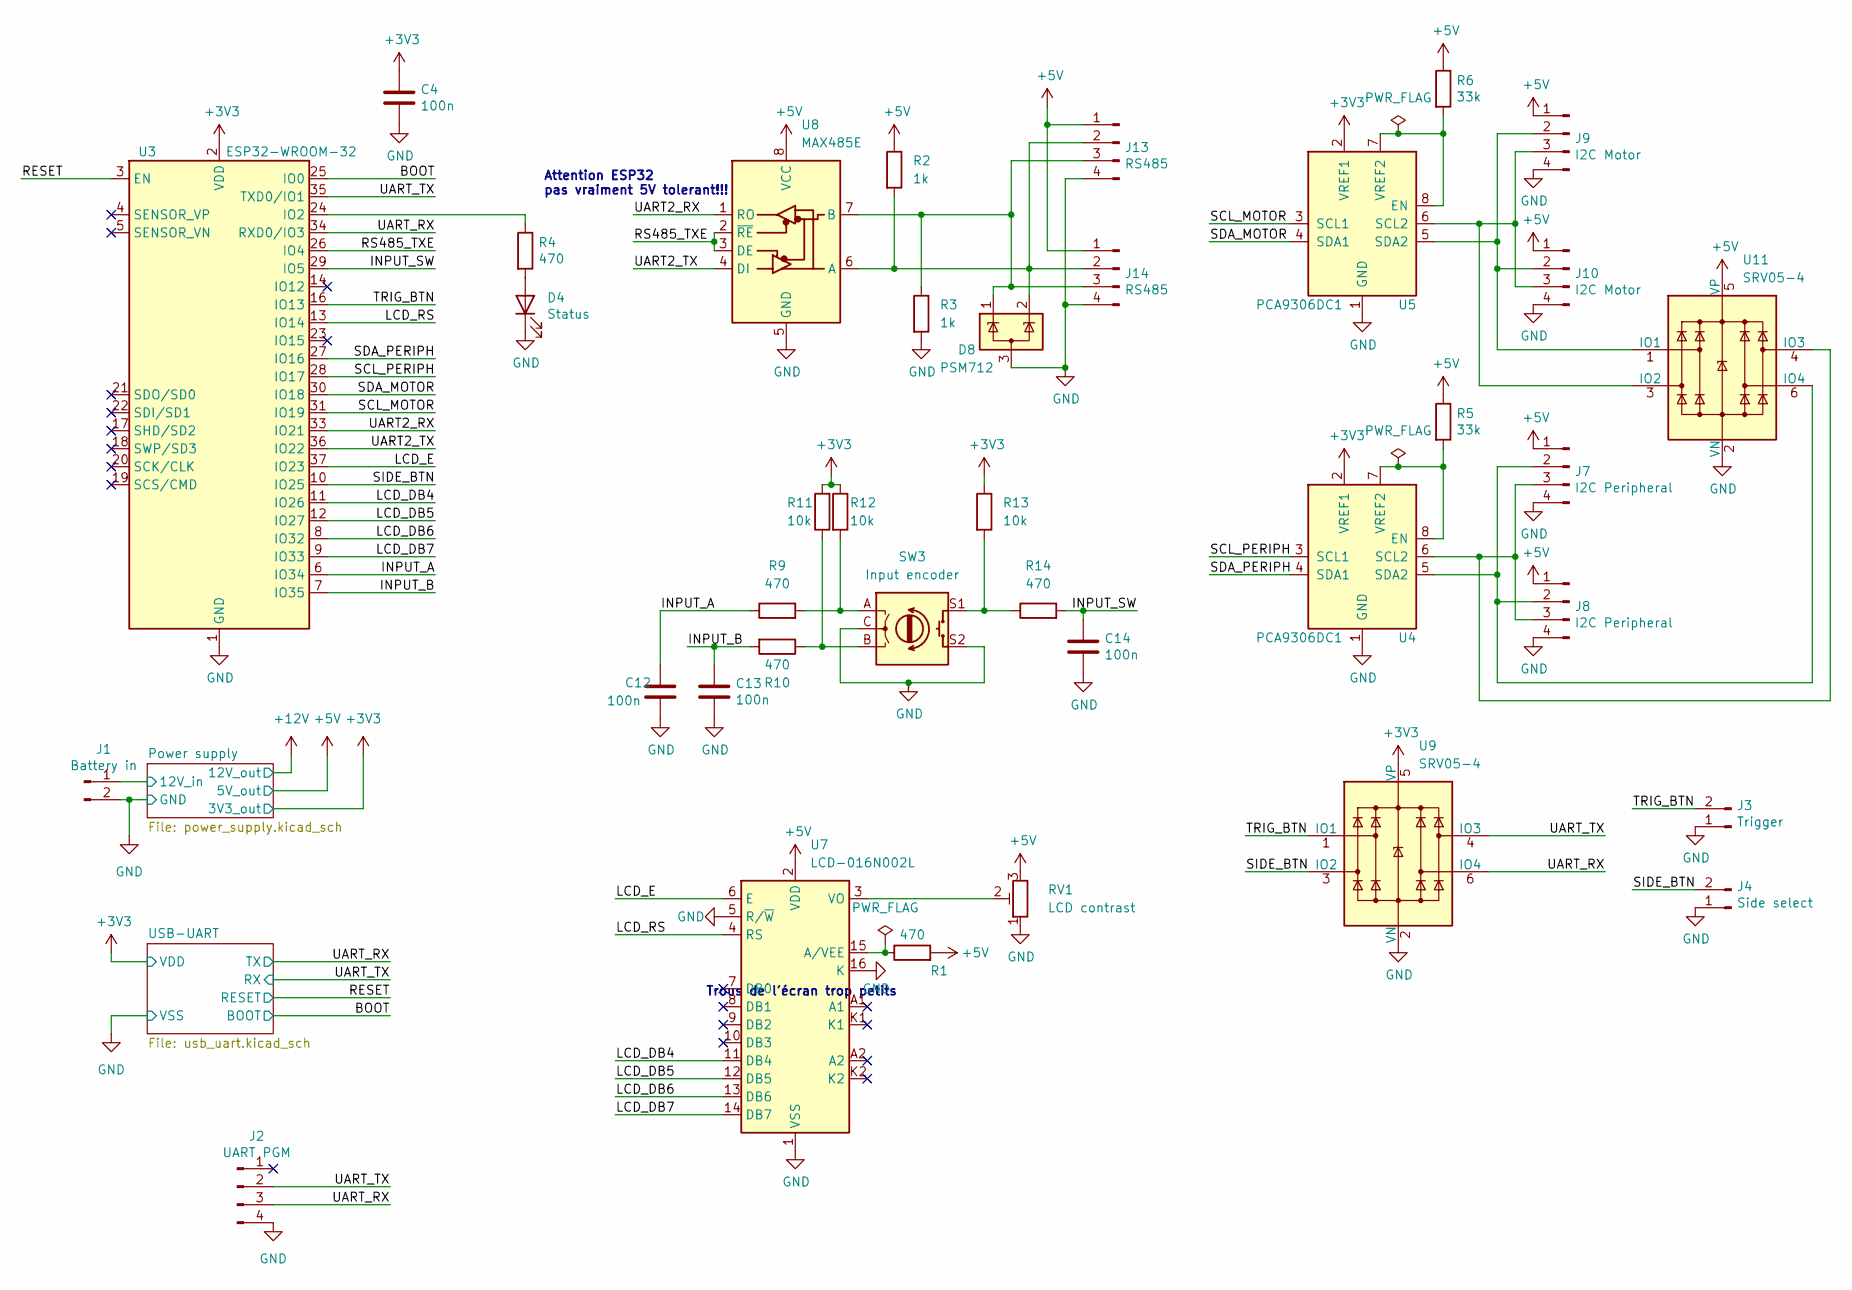
[picture p48: schematic main_board.kicad_sch]

Parts:
C4, C12, C13, C14: 100n; C_0805_2012Metric; LCSC C28233
D4: Status; LED_0603_1608Metric; LCSC C72038
D8: PSM712; SOT-23
J1: Battery in; BarrelJack_Horizontal
J2: UART PGM; Molex_KK-254_AE-6410-04A_1x04_P2.54mm_Vertical
J3: Trigger; Molex_KK-254_AE-6410-02A_1x02_P2.54mm_Vertical
J4: Side select; Molex_KK-254_AE-6410-02A_1x02_P2.54mm_Vertical
J7, J8: I2C Peripheral; Molex_KK-254_AE-6410-04A_1x04_P2.54mm_Vertical
J9, J10: I2C Motor; Molex_KK-254_AE-6410-04A_1x04_P2.54mm_Vertical
J13, J14: RS485; Molex_KK-254_AE-6410-04A_1x04_P2.54mm_Vertical
R1: 470; R_1206_3216Metric
R2, R3: 1k; R_0603_1608Metric
R4: 470; R_1206_3216Metric; LCSC C17901
R5, R6: 33k; R_0603_1608Metric; LCSC C17900
R9, R10, R14: 470; R_0603_1608Metric
R11, R12, R13: 10k; R_0603_1608Metric
RV1: LCD contrast; Potentiometer_Bourns_3314J_Vertical
SW3: Input encoder; RotaryEncoder_Alps_EC11E-Switch_Vertical_H20mm
U3: ESP32-WROOM-32; ESP32-WROOM-32U; LCSC C82899
U4, U5: PCA9306DC1; VSSOP-8_2.3x2mm_P0.5mm
U7: LCD-016N002L; WC1602A
U8: MAX485E; SOIC-8_3.9x4.9mm_P1.27mm
U9, U11: SRV05-4; SOT-23-6

Connections:
+3V3: C4.1, R11.2, R12.1, R13.1, U3.2 (VDD), U4.2 (VREF1), U5.2 (VREF1), U9.5 (VP); also elsewhere on the board
+5V: J7.1, J8.1, J9.1, J10.1, J13.1, J14.1, R1.2, R2.1, R5.1, R6.1, RV1.3, U7.2 (VDD), U8.8 (VCC), U11.5 (VP); also elsewhere on the board
/BOOT: U3.25 (IO0); also elsewhere on the board
/INPUT_A: C12.1, R9.1, U3.6 (IO34)
/INPUT_B: C13.1, R10.2, U3.7 (IO35)
/INPUT_SW: C14.1, R14.2, U3.29 (IO5)
/LCD_DB4: U3.11 (IO26), U7.11 (DB4)
/LCD_DB5: U3.12 (IO27), U7.12 (DB5)
/LCD_DB6: U3.8 (IO32), U7.13 (DB6)
/LCD_DB7: U3.9 (IO33), U7.14 (DB7)
/LCD_E: U3.37 (IO23), U7.6 (E)
/LCD_RS: U3.13 (IO14), U7.4 (RS)
/Power supply/12V_in: J1.1; also elsewhere on the board
/RESET: U3.3 (EN); also elsewhere on the board
/RS485_TXE: U3.26 (IO4), U8.2 (~RE), U8.3 (DE)
/SCL_MOTOR: U3.31 (IO19), U5.3 (SCL1)
/SCL_PERIPH: U3.28 (IO17), U4.3 (SCL1)
/SDA_MOTOR: U3.30 (IO18), U5.4 (SDA1)
/SDA_PERIPH: U3.27 (IO16), U4.4 (SDA1)
/SIDE_BTN: J4.2, U3.10 (IO25), U9.3 (IO2)
/TRIG_BTN: J3.2, U3.16 (IO13), U9.1 (IO1)
/UART2_RX: U3.33 (IO21), U8.1 (RO)
/UART2_TX: U3.36 (IO22), U8.4 (DI)
/UART_RX: J2.3, U3.34 (RXD0/IO3), U9.6 (IO4); also elsewhere on the board
/UART_TX: J2.2, U3.35 (TXD0/IO1), U9.4 (IO3); also elsewhere on the board
GND: C4.2, C12.2, C13.2, C14.2, D4.1 (K), D8.3 (A), J1.2, J2.4, J3.1, J4.1, J7.4, J8.4, J9.4, J10.4, J13.4, J14.4, R3.2, RV1.1, SW3.C, SW3.S2, U3.1 (GND), U3.15 (GND), U3.38 (GND), U3.39 (GND), U4.1 (GND), U5.1 (GND), U7.1 (VSS), U7.5 (R/~W), U7.16 (K), U8.5 (GND), U9.2 (VN), U11.2 (VN); also elsewhere on the board
unnamed: D4.2 (A), R4.2
unnamed: J7.2, J8.2, U4.5 (SDA2), U11.6 (IO4)
unnamed: J7.3, J8.3, U4.6 (SCL2), U11.4 (IO3)
unnamed: J9.2, J10.2, U5.5 (SDA2), U11.1 (IO1)
unnamed: J9.3, J10.3, U5.6 (SCL2), U11.3 (IO2)
unnamed: R1.1, U7.15 (A/VEE)
unnamed: R4.1, U3.24 (IO2)
unnamed: R5.2, U4.7 (VREF2), U4.8 (EN)
unnamed: R6.2, U5.7 (VREF2), U5.8 (EN)
unnamed: R10.1, R11.1, SW3.B
unnamed: R9.2, R12.2, SW3.A
unnamed: R13.2, R14.1, SW3.S1
unnamed: RV1.2, U7.3 (VO)
unnamed: D8.2 (K), J13.2, J14.2, R2.2, U8.6 (A)
unnamed: D8.1 (K), J13.3, J14.3, R3.1, U8.7 (B)

Notes on the sheet:
Attention ESP32 pas vraiment 5V tolerant!!!
Trous de l'écran trop petits

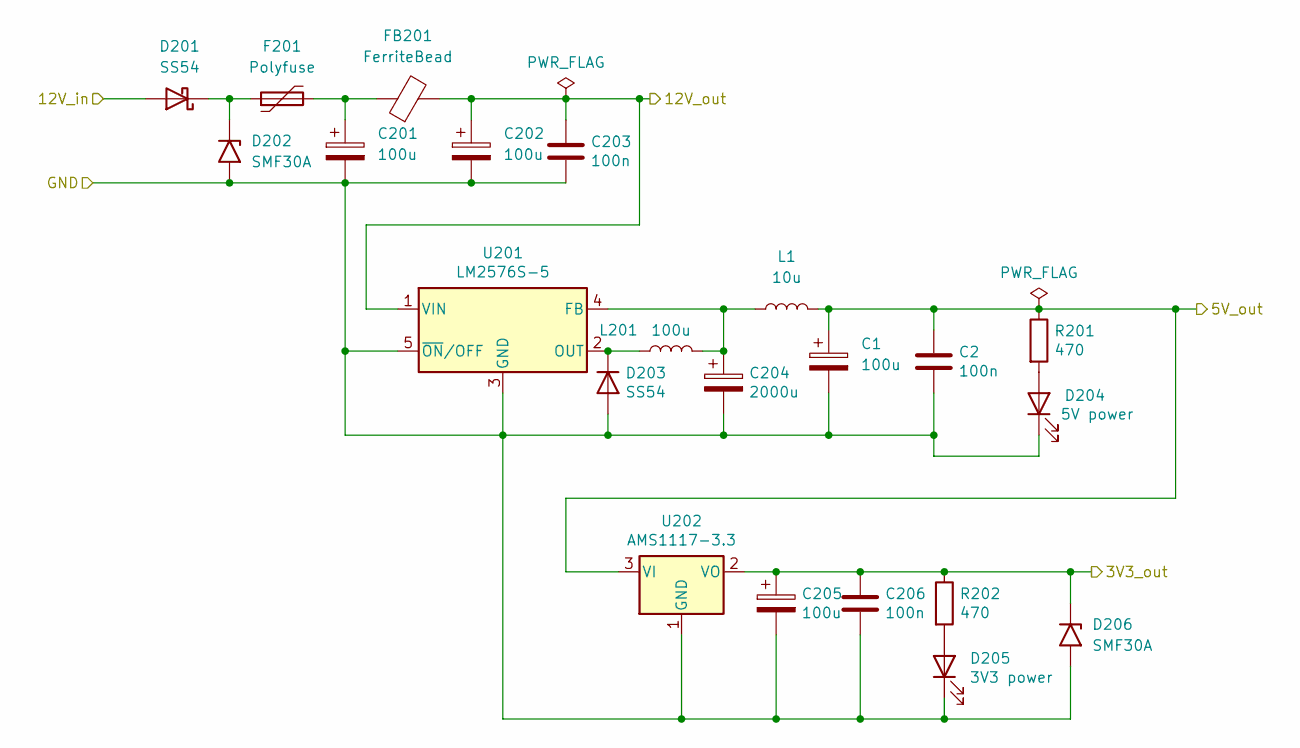
[picture p49: schematic power_supply.kicad_sch]

Parts:
C1, C201, C202, C205: 100u; CP_Elec_8x10
C2, C203, C206: 100n; C_0805_2012Metric; LCSC C28233
C204: 2000u; CP_Elec_10x10.5
D201: SS54; D_SMA
D202, D206: SMF30A; D_SMF
D203: SS54; D_SMA; LCSC C22452
D204: 5V power; LED_0603_1608Metric; LCSC C72038
D205: 3V3 power; LED_0603_1608Metric; LCSC C72038
F201: Polyfuse; Fuse_1812_4532Metric
FB201: FerriteBead; L_0805_2012Metric
L1: 10u; L_12x12mm_H6mm
L201: 100u; L_12x12mm_H6mm; LCSC C169378
R201: 470; R_1206_3216Metric; LCSC C17887
R202: 470; R_1206_3216Metric; LCSC C17901
U201: LM2576S-5; TO-263-5_TabPin3; LCSC C34465
U202: AMS1117-3.3; SOT-223-3_TabPin2; LCSC C6186

Connections:
+3V3: C205.1, C206.1, D206.1 (A1), R202.1, U202.2 (VO); also elsewhere on the board
+5V: C1.1, C2.1, L1.2, R201.1, U202.3 (VI); also elsewhere on the board
+12V: C202.1, C203.1, FB201.2, U201.1 (VIN)
/Power supply/12V_in: D201.2 (A); also elsewhere on the board
GND: C1.2, C2.2, C201.2, C202.2, C203.2, C204.2, C205.2, C206.2, D202.2 (A2), D203.2 (A), D204.1 (K), D205.1 (K), D206.2 (A2), U201.3 (GND), U201.5 (~ON/OFF), U202.1 (GND); also elsewhere on the board
unnamed: C201.1, F201.2, FB201.1
unnamed: C204.1, L1.1, L201.2, U201.4 (FB)
unnamed: D201.1 (K), D202.1 (A1), F201.1
unnamed: D203.1 (K), L201.1, U201.2 (OUT)
unnamed: D204.2 (A), R201.2
unnamed: D205.2 (A), R202.2

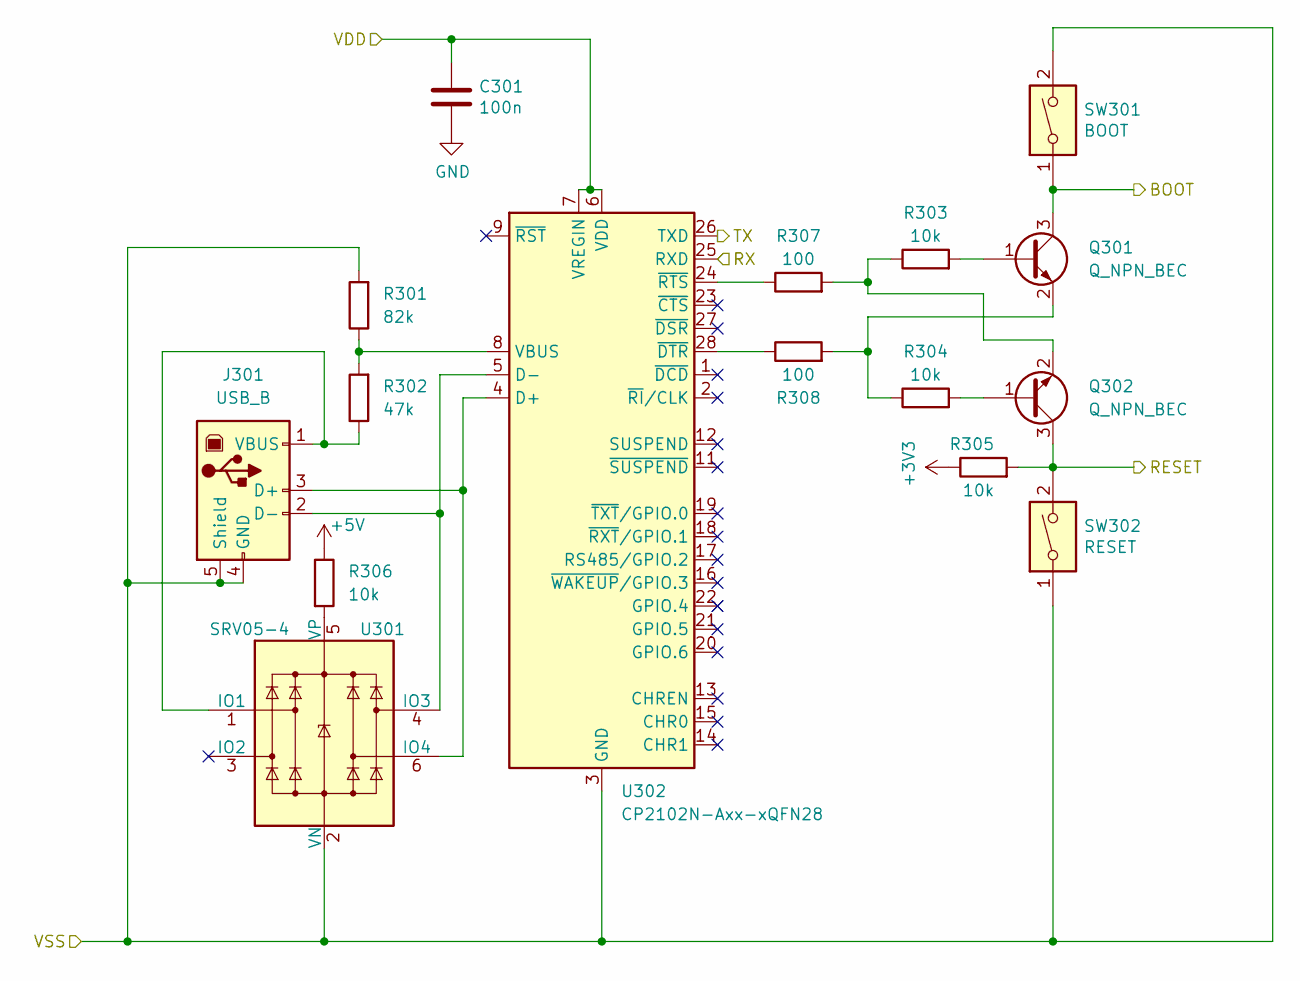
[picture p50: schematic usb_uart.kicad_sch]

Parts:
C301: 100n; C_0805_2012Metric; LCSC C28233
J301: USB_B; USB_B_TE_5787834_Vertical
Q301, Q302: Q_NPN_BEC; SOT-23
R301: 82k; R_0603_1608Metric
R302: 47k; R_0603_1608Metric
R303, R304, R306: 10k; R_0603_1608Metric
R305: 10k; R_0603_1608Metric; LCSC C17902
R307, R308: 100; R_0603_1608Metric
SW301: BOOT; SW_Push_1P1T_NO_6x6mm_H9.5mm
SW302: RESET; SW_Push_1P1T_NO_6x6mm_H9.5mm
U301: SRV05-4; SOT-23-6
U302: CP2102N-Axx-xQFN28; QFN-28-1EP_5x5mm_P0.5mm_EP3.35x3.35mm

Connections:
+3V3: C301.1, R305.1, U302.6 (VDD), U302.7 (VREGIN); also elsewhere on the board
+5V: R306.1; also elsewhere on the board
/BOOT: Q301.3 (C), SW301.1; also elsewhere on the board
/RESET: Q302.3 (C), R305.2, SW302.2; also elsewhere on the board
/UART_RX: U302.26 (TXD); also elsewhere on the board
/UART_TX: U302.25 (RXD); also elsewhere on the board
GND: C301.2, J301.4 (GND), J301.5 (Shield), R301.2, SW301.2, SW302.1, U301.2 (VN), U302.3 (GND), U302.29 (GND); also elsewhere on the board
unnamed: J301.1 (VBUS), R302.1, U301.1 (IO1)
unnamed: J301.2 (D-), U301.4 (IO3), U302.5 (D-)
unnamed: J301.3 (D+), U301.6 (IO4), U302.4 (D+)
unnamed: Q301.1 (B), R303.2
unnamed: Q301.2 (E), R304.1, R308.2
unnamed: Q302.1 (B), R304.2
unnamed: Q302.2 (E), R303.1, R307.2
unnamed: R301.1, R302.2, U302.8 (VBUS)
unnamed: R306.2, U301.5 (VP)
unnamed: R307.1, U302.24 (~RTS)
unnamed: R308.1, U302.28 (~DTR)

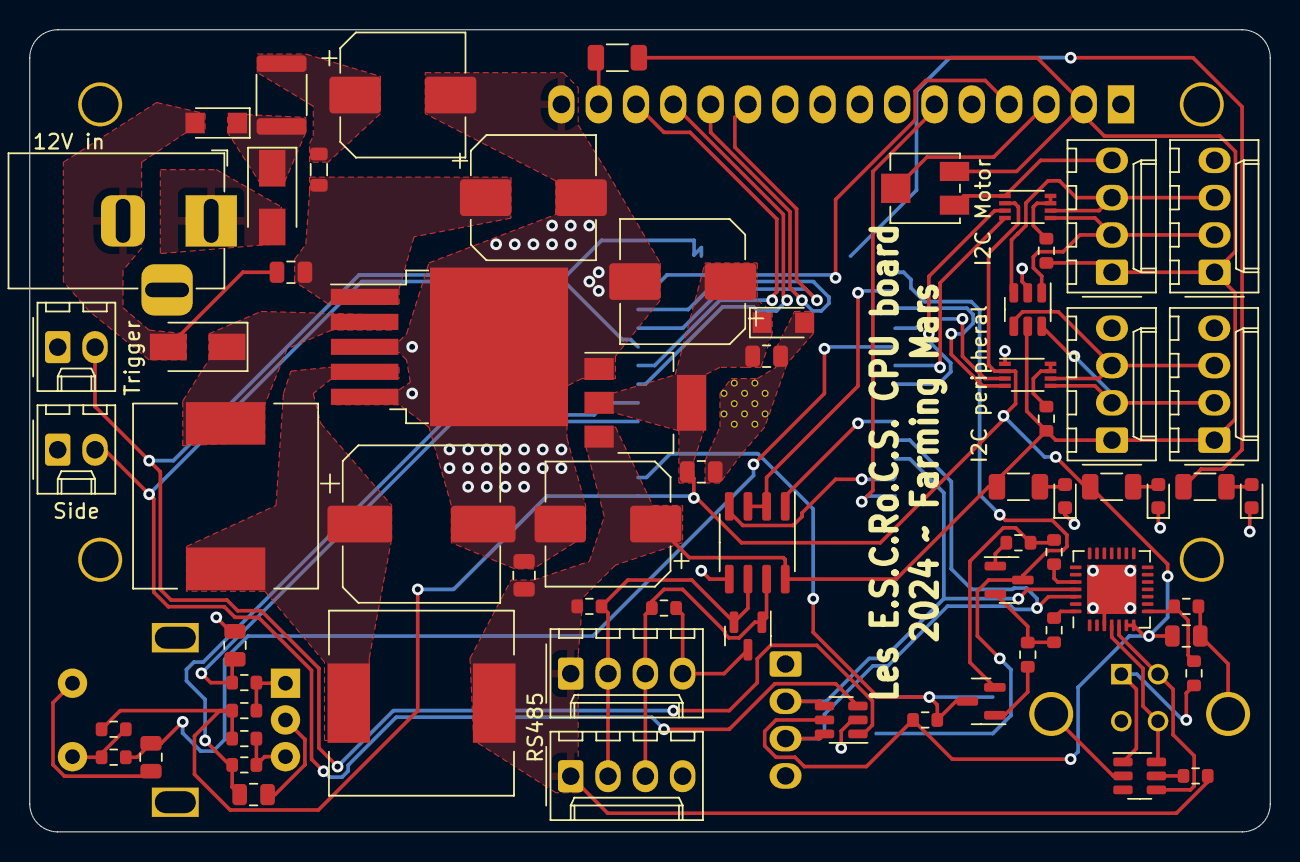
[picture p51: board main_board.kicad_pcb from above]

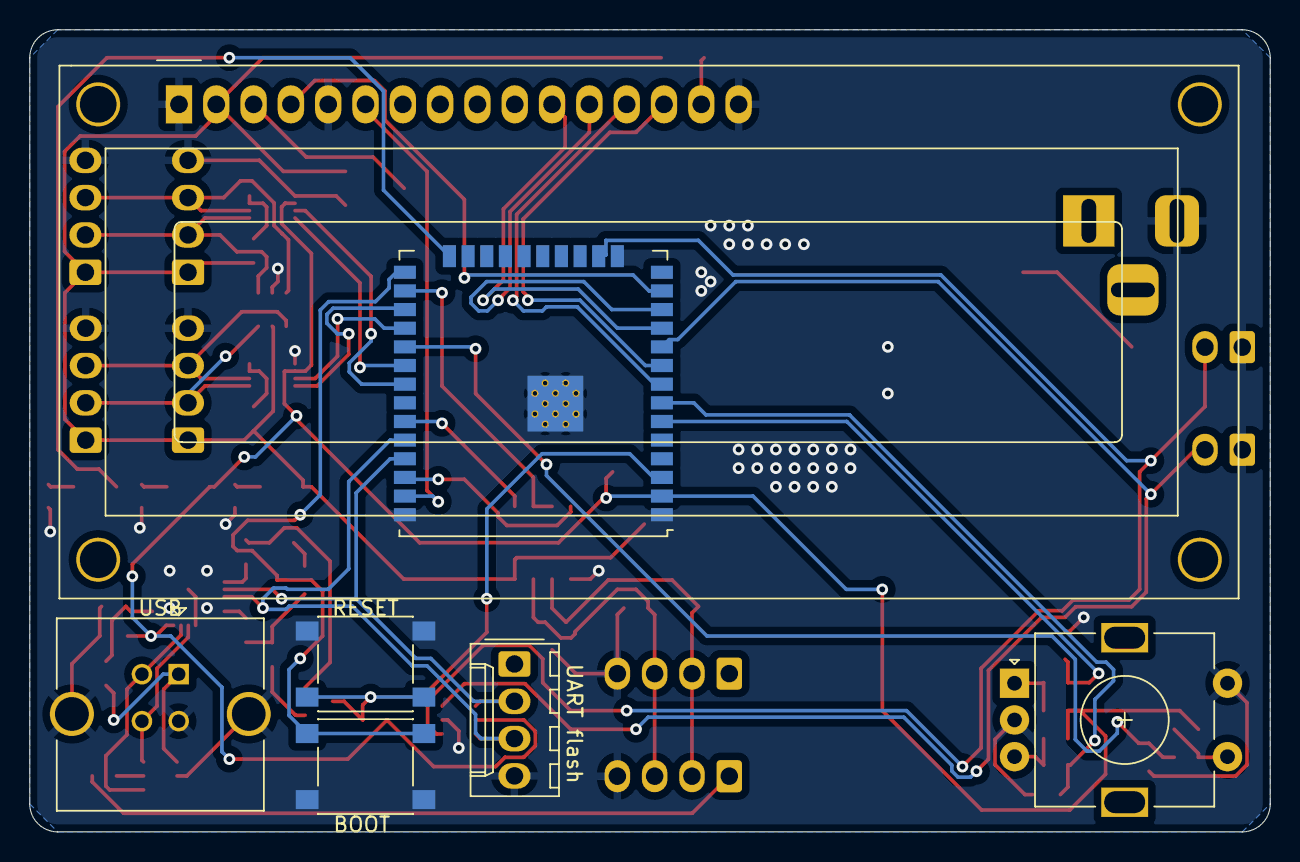
[picture p52: board main_board.kicad_pcb from below]

Board: 2 copper layers, 84.5 x 54.6 mm, 75 parts (7 on the bottom side), 59 nets.
