felixzero/escrocs/CAD/electrical/motor_board_v3/motor_board_v3.kicad_pcb

## KiCad design CAD/electrical/motor_board_v3/motor_board_v3.kicad_pcb (2023-07-21)

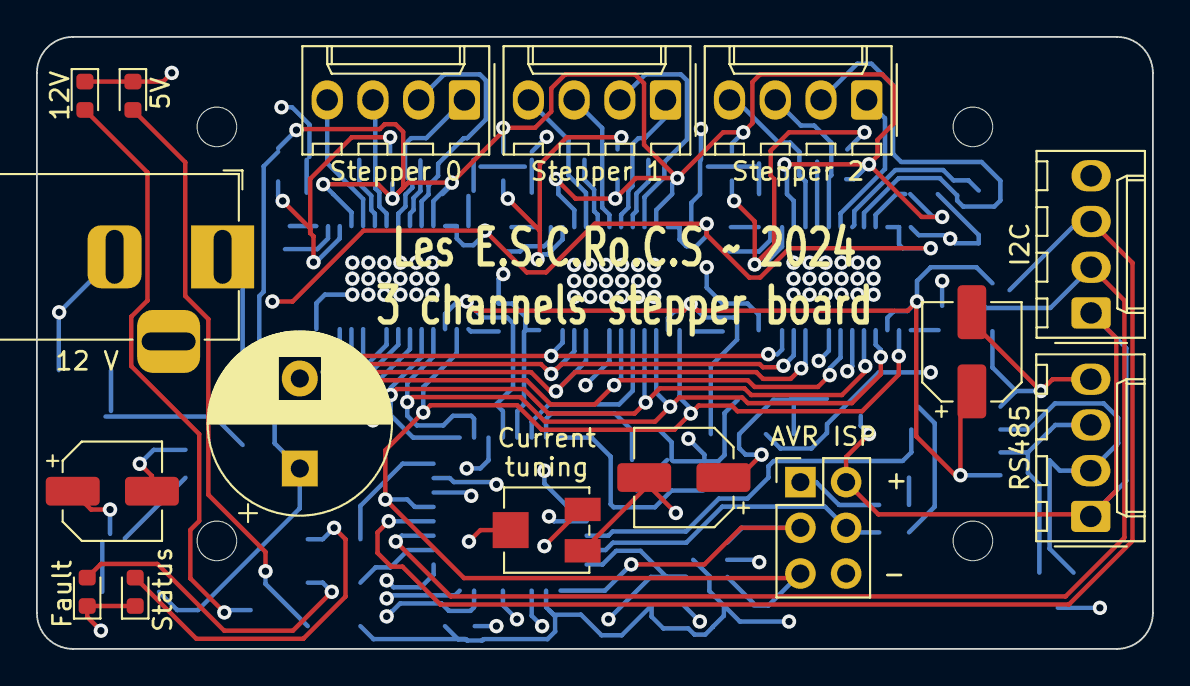
[picture p53: board motor_board_v3.kicad_pcb from above]

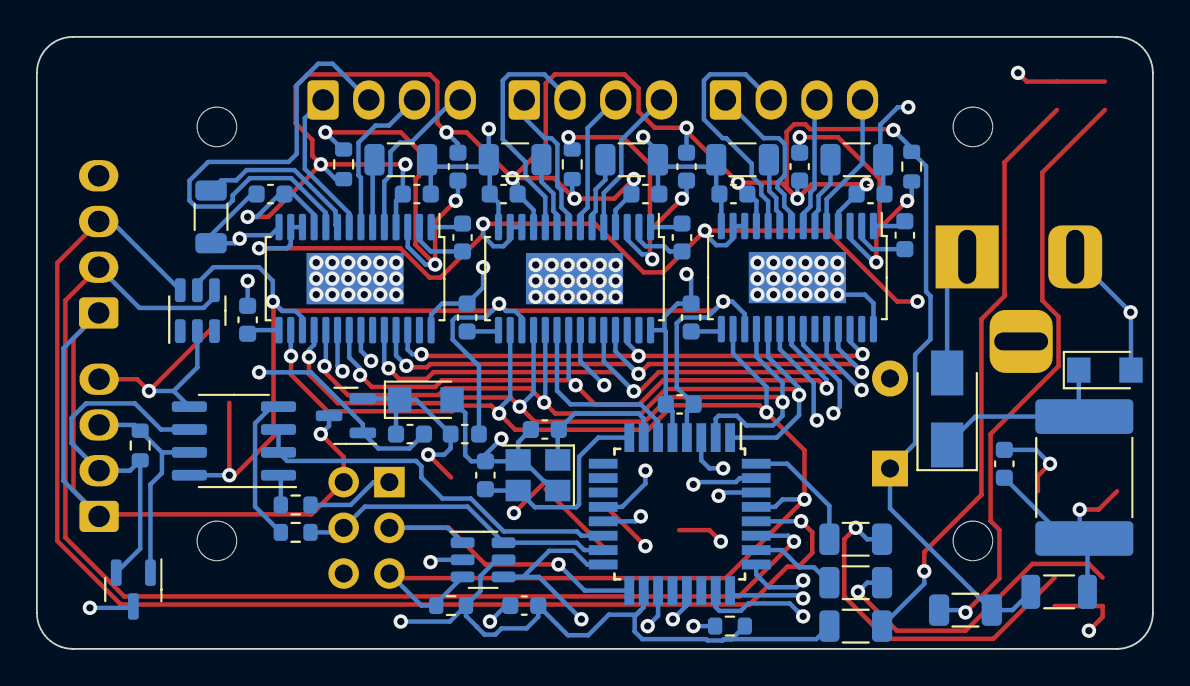
[picture p54: board motor_board_v3.kicad_pcb from below]

Board: 4 copper layers, 62.0 x 34.0 mm, 71 parts (55 on the bottom side), 71 nets.

Parts:
C1, C2, C4, C6, C8, C9, C10, C14, C15, C16, C20, C21, C22: 100n; C_0603_1608Metric
C3, C5, C31: 10u; CP_Elec_5x5.4
C7, C13, C19: 10n 50V; C_0603_1608Metric
C11, C17: 22p; C_0603_1608Metric
C12, C18, C24: 0.47u; C_0603_1608Metric
C30: 100u; CP_Radial_D10.0mm_P5.00mm
D1: Fault; LED_0603_1608Metric
D2: ST; LED_0603_1608Metric
D3: 5V; LED_0603_1608Metric
D5: SS54; D_SMA
D6, D7: SMF30A; D_SMF
D8: 12V; LED_0603_1608Metric
D9: PSM712; SOT-23
F1: 2920L700SLPR; Fuse_2920_7451Metric
FB1: BLM31PG330SZ1L; L_1206_3216Metric
FB2: GZ1608D601TF; L_0603_1608Metric
J1: AVR-ISP-6; PinHeader_2x03_P2.54mm_Vertical
J2: 12V; BarrelJack_Horizontal
J3: I2C; Molex_KK-254_AE-6410-04A_1x04_P2.54mm_Vertical
J4: RS485; Molex_KK-254_AE-6410-04A_1x04_P2.54mm_Vertical
J5, J6, J7: Stepper; Molex_KK-254_AE-6410-04A_1x04_P2.54mm_Vertical
Q1: SI2301CDS-T1-GE3; SOT-23
R1, R4, R6, R7: 470; R_1206_3216Metric
R2, R3: 330; R_0603_1608Metric
R5: 120R; R_0603_1608Metric
R9, R12, R15: 1M; R_0603_1608Metric
R10, R11, R13, R14, R16, R17: 0.1; R_1206_3216Metric
R18, R19: 10k; R_0603_1608Metric
RV1: 4.7k; Potentiometer_Bourns_3314J_Vertical
U1: ATmega328PB-A; TQFP-32_7x7mm_P0.8mm
U2: MAX485E; SOIC-8_3.9x4.9mm_P1.27mm
U3, U4, U5: DRV8825; HTSSOP-28-1EP_4.4x9.7mm_P0.65mm_EP2.85x5.4mm
U6, U8: SRV05-4; SOT-23-6
Y1: 16MHz; Crystal_SMD_3225-4Pin_3.2x2.5mm

Connections:
+5V: C1.1, C2.1, C31.1, FB2.2, R7.1, R18.1, R19.1, U1.4 (VCC), U1.18 (AVCC), U2.8 (VCC), U3.17 (nSLEEP), U4.17 (nSLEEP), U5.17 (nSLEEP), U6.5 (VP), U8.5 (VP)
+12V: C8.2, C9.1, C10.1, C14.2, C15.1, C16.1, C20.2, C21.1, C22.1, C30.1, FB1.2, R1.1, R9.2, R12.2, R15.2, U3.4 (VMA), U3.11 (VMB), U4.4 (VMA), U4.11 (VMB), U5.4 (VMA), U5.11 (VMB)
/DECAY: U1.1 (PD3), U3.19 (DECAY), U4.19 (DECAY), U5.19 (DECAY)
/DIR0: U1.3 (PE0), U3.20 (DIR)
/DIR1: U1.6 (PE1), U4.20 (DIR)
/DIR2: U1.19 (PE2), U5.20 (DIR)
/FAULT: U1.2 (PD4), U3.18 (nFAULT), U4.18 (nFAULT), U5.18 (nFAULT)
/FAULT_ST: R4.1, U1.26 (PC3)
/I2C_SCL: J3.3, U1.28 (PC5), U8.6 (IO4)
/I2C_SDA: J3.2, U1.27 (PC4), U8.4 (IO3)
/MODE0: U1.23 (PC0), U3.24 (MODE0), U4.24 (MODE0), U5.24 (MODE0)
/MODE1: U1.24 (PC1), U3.25 (MODE1), U4.25 (MODE1), U5.25 (MODE1)
/MODE2: U1.25 (PC2), U3.26 (MODE2), U4.26 (MODE2), U5.26 (MODE2)
/RAW_5V: J1.2 (VCC), J3.1, J4.1, Q1.3 (D)
/RS485_A: D9.1 (K), J4.3, R5.1, U2.7 (B)
/RS485_B: D9.2 (K), J4.2, R5.2, U2.6 (A)
/RS485_TXE: U1.14 (PB2), U2.2 (~RE), U2.3 (DE)
/RST: J1.5 (~RST), R19.2, U1.29 (~RESET/PC6), U3.16 (nRESET), U4.16 (nRESET), U5.16 (nRESET), U6.3 (IO2)
/SPI_MISO: J1.1 (MISO), R3.1, U1.16 (PB4), U6.4 (IO3)
/SPI_MOSI: J1.4 (MOSI), R2.1, U1.15 (PB3), U6.6 (IO4)
/SPI_SCK: J1.3 (SCK), U1.17 (PB5), U6.1 (IO1)
/STATUS: R6.1, U1.32 (PD2)
/STEP0: U1.13 (PB1), U3.22 (STEP)
/STEP1: U1.30 (PD0), U4.22 (STEP)
/STEP2: U1.31 (PD1), U5.22 (STEP)
/STEP_EN: U1.12 (PB0), U3.21 (nENBL), U4.21 (nENBL), U5.21 (nENBL)
/Stepper module/VREF: RV1.2, U3.12 (AVREF), U3.13 (BVREF), U4.12 (AVREF), U4.13 (BVREF), U5.12 (AVREF), U5.13 (BVREF)
/UART_RXD: R3.2, U2.1 (RO)
/UART_TXD: R2.2, U2.4 (DI)
/XTAL1: C11.1, U1.7 (XTAL1/PB6), Y1.1
/XTAL2: C17.1, U1.8 (XTAL2/PB7), Y1.3
GND: C1.2, C2.2, C3.2, C4.2, C5.2, C6.2, C9.2, C10.2, C11.2, C12.2, C15.2, C16.2, C17.2, C18.2, C21.2, C22.2, C24.2, C30.2, C31.2, D1.1 (K), D2.1 (K), D3.1 (K), D6.2 (A2), D7.2 (A2), D8.1 (K), D9.3 (A), J1.6 (GND), J2.2, J3.4, J4.4, Q1.1 (G), R10.2, R11.2, R13.2, R14.2, R16.2, R17.2, RV1.1, U1.5 (GND), U1.21 (GND), U2.5 (GND), U3.14 (GND), U3.28 (GND), U3.29 (PAD), U4.14 (GND), U4.28 (GND), U4.29 (PAD), U5.14 (GND), U5.28 (GND), U5.29 (PAD), U6.2 (VN), U8.2 (VN), Y1.2, Y1.4
unnamed: C3.1, C4.1, D7.1 (A1), FB2.1, Q1.2 (S)
unnamed: C5.1, C6.1, F1.1, FB1.1
unnamed: C7.1, U3.1 (CP1)
unnamed: C7.2, U3.2 (CP2)
unnamed: C8.1, R9.1, U3.3 (VCP)
unnamed: C12.1, U5.15 (V3P3OUT)
unnamed: C13.1, U4.1 (CP1)
unnamed: C13.2, U4.2 (CP2)
unnamed: C14.1, R12.1, U4.3 (VCP)
unnamed: C18.1, U3.15 (V3P3OUT)
unnamed: C19.1, U5.1 (CP1)
unnamed: C19.2, U5.2 (CP2)
unnamed: C20.1, R15.1, U5.3 (VCP)
unnamed: C24.1, U4.15 (V3P3OUT)
unnamed: D1.2 (A), R4.2
unnamed: D2.2 (A), R6.2
unnamed: D3.2 (A), R7.2
unnamed: D5.1 (K), D6.1 (A1), F1.2
unnamed: D5.2 (A), J2.1
unnamed: D8.2 (A), R1.2
unnamed: J5.1, U3.8 (BOUT2)
unnamed: J5.2, U3.10 (BOUT1)
unnamed: J5.3, U3.7 (AOUT2)
unnamed: J5.4, U3.5 (AOUT1)
unnamed: J6.1, U4.8 (BOUT2)
unnamed: J6.2, U4.10 (BOUT1)
unnamed: J6.3, U4.7 (AOUT2)
unnamed: J6.4, U4.5 (AOUT1)
unnamed: J7.1, U5.8 (BOUT2)
unnamed: J7.2, U5.10 (BOUT1)
unnamed: J7.3, U5.7 (AOUT2)
unnamed: J7.4, U5.5 (AOUT1)
unnamed: R10.1, U3.9 (ISENB)
unnamed: R11.1, U3.6 (ISENA)
unnamed: R13.1, U4.9 (ISENB)
unnamed: R14.1, U4.6 (ISENA)
unnamed: R16.1, U5.9 (ISENB)
unnamed: R17.1, U5.6 (ISENA)
unnamed: R18.2, RV1.3
