felixzero/escrocs/CAD/electrical/ultrasonic_board/ultrasonic_board.kicad_pcb

## KiCad design CAD/electrical/ultrasonic_board/ultrasonic_board.kicad_pcb (2023-03-11)

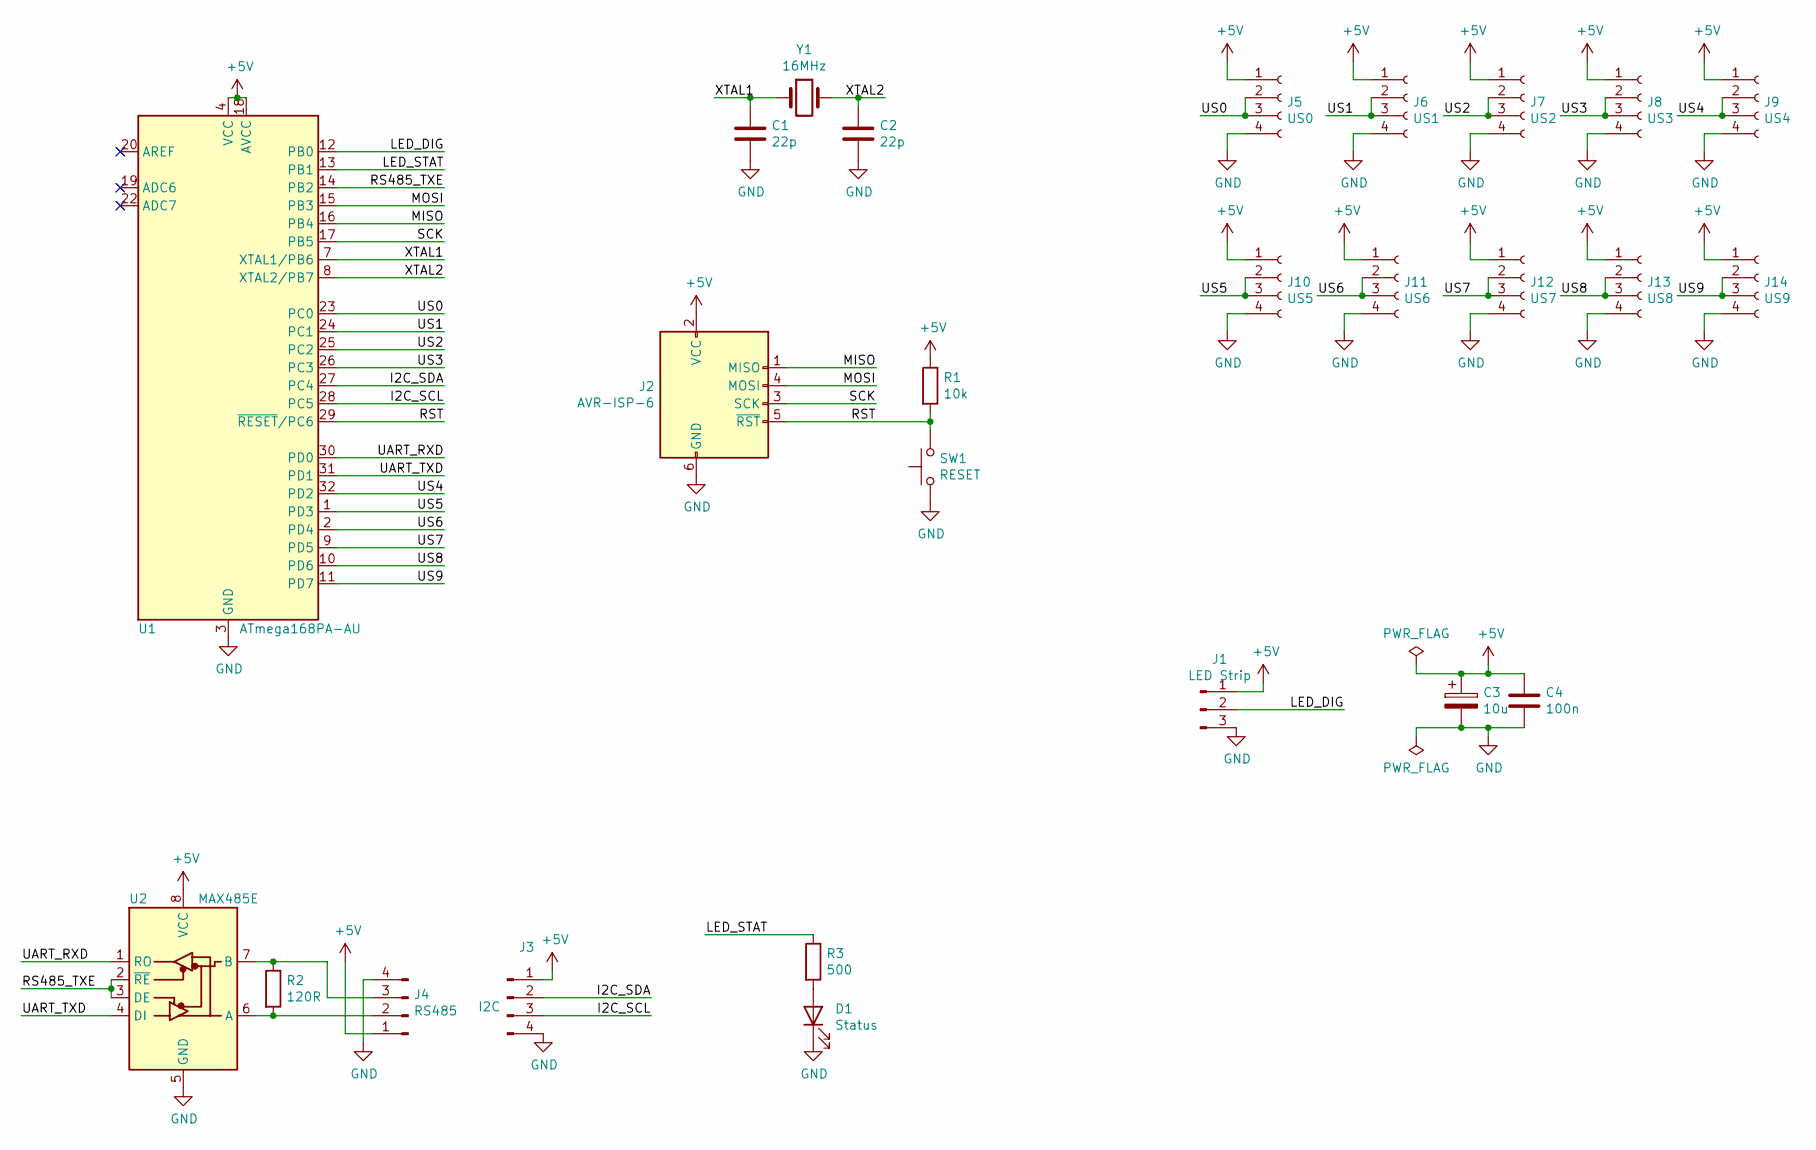
[picture p55: schematic ultrasonic_board.kicad_sch]

Parts:
C1, C2: 22p; C_0603_1608Metric
C3: 10u; CP_Radial_D8.0mm_P3.80mm
C4: 100n; C_0603_1608Metric
D1: Status; LED_0805_2012Metric
J1: LED Strip; Molex_KK-254_AE-6410-03A_1x03_P2.54mm_Vertical
J2: AVR-ISP-6; PinHeader_2x03_P2.54mm_Vertical
J3: I2C; Molex_KK-254_AE-6410-04A_1x04_P2.54mm_Vertical
J4: RS485; Molex_KK-254_AE-6410-04A_1x04_P2.54mm_Vertical
J5: US0; PinSocket_1x04_P2.54mm_Vertical
J6: US1; PinSocket_1x04_P2.54mm_Vertical
J7: US2; PinSocket_1x04_P2.54mm_Vertical
J8: US3; PinSocket_1x04_P2.54mm_Vertical
J9: US4; PinSocket_1x04_P2.54mm_Vertical
J10: US5; PinSocket_1x04_P2.54mm_Vertical
J11: US6; PinSocket_1x04_P2.54mm_Vertical
J12: US7; PinSocket_1x04_P2.54mm_Vertical
J13: US8; PinSocket_1x04_P2.54mm_Vertical
J14: US9; PinSocket_1x04_P2.54mm_Vertical
R1: 10k; R_0603_1608Metric
R2: 120R; R_0603_1608Metric
R3: 500; R_0603_1608Metric
SW1: RESET; SW_PUSH_6mm
U1: ATmega168PA-AU; TQFP-32_7x7mm_P0.8mm
U2: MAX485E; SOIC-8_3.9x4.9mm_P1.27mm
Y1: 16MHz; Crystal_SMD_HC49-SD

Connections:
+5V: C3.1, C4.1, J1.1, J2.2 (VCC), J3.1, J4.1, J5.1, J6.1, J7.1, J8.1, J9.1, J10.1, J11.1, J12.1, J13.1, J14.1, R1.1, U1.4 (VCC), U1.6 (VCC), U1.18 (AVCC), U2.8 (VCC)
/I2C_SCL: J3.3, U1.28 (PC5)
/I2C_SDA: J3.2, U1.27 (PC4)
/LED_DIG: J1.2, U1.12 (PB0)
/LED_STAT: R3.1, U1.13 (PB1)
/MISO: J2.1 (MISO), U1.16 (PB4)
/MOSI: J2.4 (MOSI), U1.15 (PB3)
/RS485_TXE: U1.14 (PB2), U2.2 (~RE), U2.3 (DE)
/RST: J2.5 (~RST), R1.2, SW1.2, U1.29 (~RESET/PC6)
/SCK: J2.3 (SCK), U1.17 (PB5)
/UART_RXD: U1.30 (PD0), U2.1 (RO)
/UART_TXD: U1.31 (PD1), U2.4 (DI)
/US0: J5.2, J5.3, U1.23 (PC0)
/US1: J6.2, J6.3, U1.24 (PC1)
/US2: J7.2, J7.3, U1.25 (PC2)
/US3: J8.2, J8.3, U1.26 (PC3)
/US4: J9.2, J9.3, U1.32 (PD2)
/US5: J10.2, J10.3, U1.1 (PD3)
/US6: J11.2, J11.3, U1.2 (PD4)
/US7: J12.2, J12.3, U1.9 (PD5)
/US8: J13.2, J13.3, U1.10 (PD6)
/US9: J14.2, J14.3, U1.11 (PD7)
/XTAL1: C1.1, U1.7 (XTAL1/PB6), Y1.1
/XTAL2: C2.1, U1.8 (XTAL2/PB7), Y1.2
GND: C1.2, C2.2, C3.2, C4.2, D1.1 (K), J1.3, J2.6 (GND), J3.4, J4.4, J5.4, J6.4, J7.4, J8.4, J9.4, J10.4, J11.4, J12.4, J13.4, J14.4, SW1.1, U1.3 (GND), U1.5 (GND), U1.21 (GND), U2.5 (GND)
unnamed: D1.2 (A), R3.2
unnamed: J4.2, R2.2, U2.6 (A)
unnamed: J4.3, R2.1, U2.7 (B)

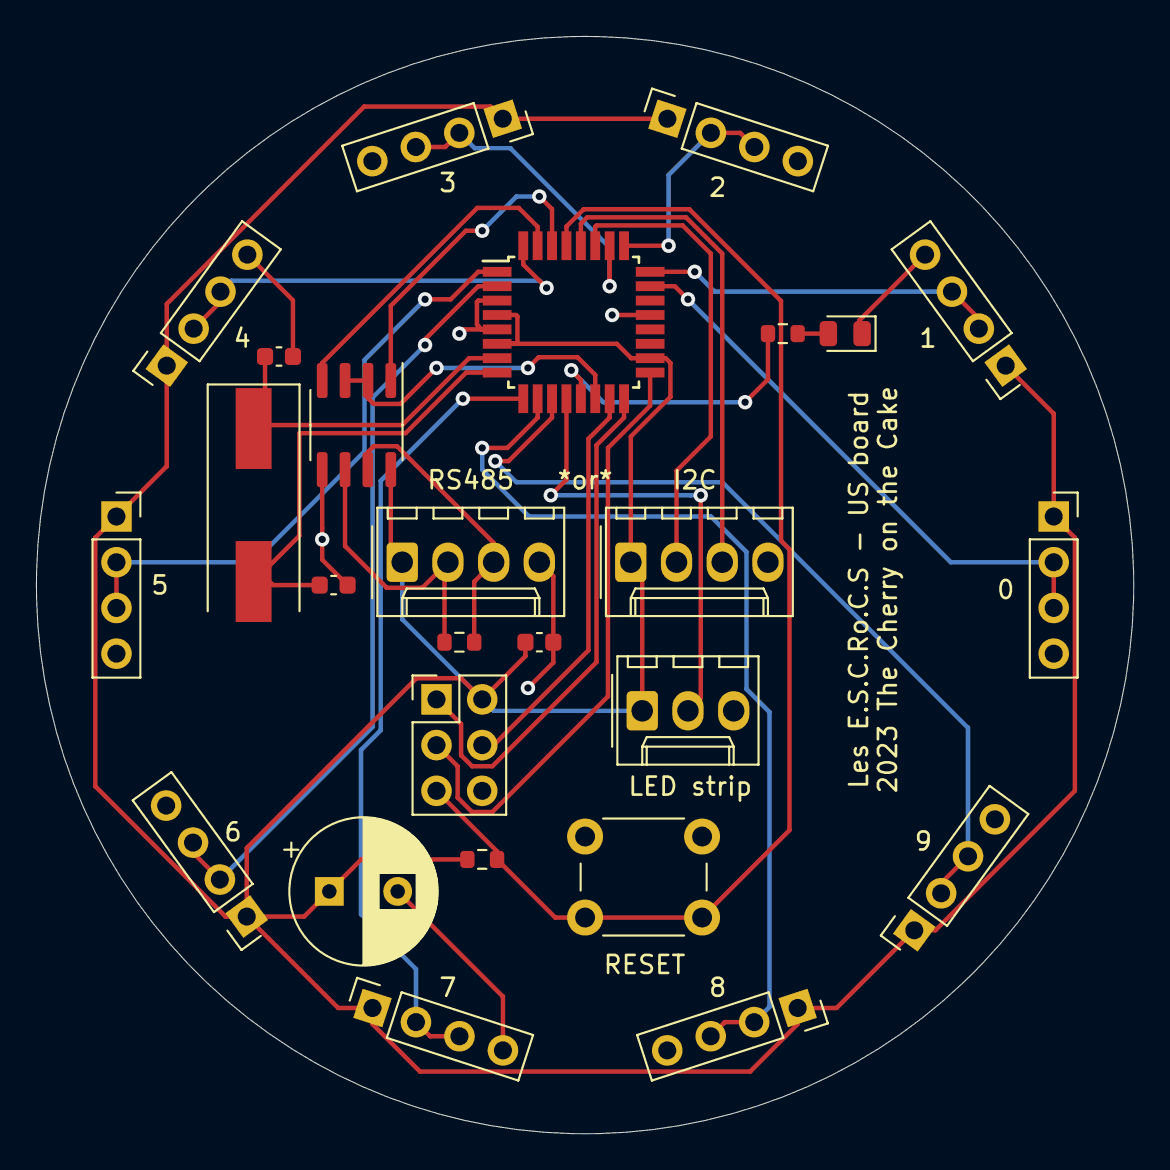
[picture p56: board ultrasonic_board.kicad_pcb from above]

Board: 2 copper layers, 61.0 x 61.0 mm, 26 parts (0 on the bottom side), 28 nets.
