felixzero/escrocs/CAD/electrical/stepper_board/stepper_board.kicad_pcb

## KiCad design CAD/electrical/stepper_board/stepper_board.kicad_pcb (2022-01-13)

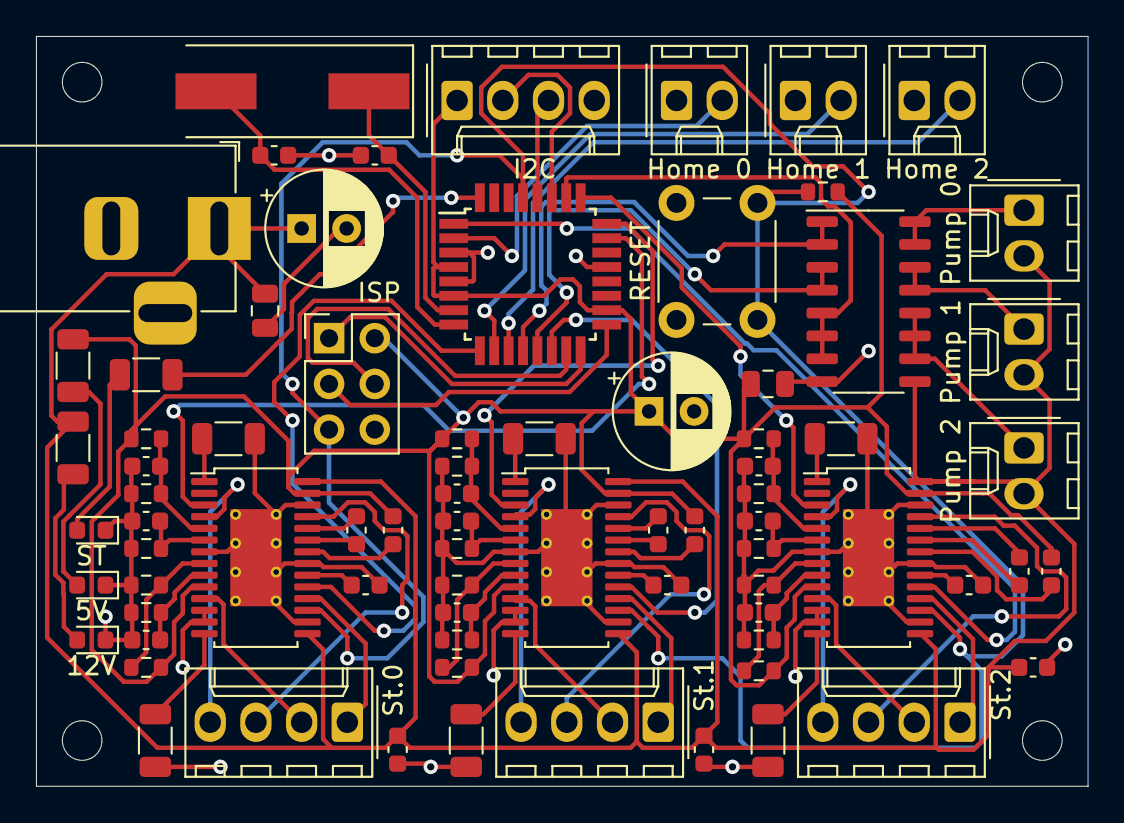
[picture p57: board stepper_board.kicad_pcb from above]

Board: 2 copper layers, 58.4 x 41.7 mm, 77 parts (0 on the bottom side), 72 nets.

Parts:
5V: 5V; LED_0603_1608Metric
12V: 12V; LED_0603_1608Metric
C1, C7, C13, C15, C17, C25: 100n; C_0603_1608Metric
C2, C3, C8, C9, C26, C27: 1n; C_0603_1608Metric
C4, C5, C6, C10, C11, C12, C28, C29, C30: 220n; C_0603_1608Metric
C14, C18: 10u; CP_Radial_D6.3mm_P2.50mm
C16, C19: 100n; C_0805_2012Metric
C20, C24: 22p; C_0603_1608Metric
Home 0: Home 0; Molex_KK-254_AE-6410-02A_1x02_P2.54mm_Vertical
Home 1: Home 1; Molex_KK-254_AE-6410-02A_1x02_P2.54mm_Vertical
Home 2: Home 2; Molex_KK-254_AE-6410-02A_1x02_P2.54mm_Vertical
I2C: I2C; Molex_KK-254_AE-6410-04A_1x04_P2.54mm_Vertical
ISP: ISP; PinHeader_2x03_P2.54mm_Vertical
J3: 12V; BarrelJack_Horizontal
Pump 0: Pump 0; Molex_KK-254_AE-6410-02A_1x02_P2.54mm_Vertical
Pump 1: Pump 1; Molex_KK-254_AE-6410-02A_1x02_P2.54mm_Vertical
Pump 2: Pump 2; Molex_KK-254_AE-6410-02A_1x02_P2.54mm_Vertical
R1, R4, R9, R12, R29, R32: 47k; R_0603_1608Metric
R2, R3, R6, R10, R11, R14, R28, R30, R31, R34: 10k; R_0603_1608Metric
R5, R13, R33: 33k; R_0603_1608Metric
R7, R8, R15, R16, R35, R36: 0.1; R_1206_3216Metric
R25, R26, R27: 470; R_1206_3216Metric
RESET: RESET; SW_PUSH_6mm
ST: ST; LED_0603_1608Metric
St.0, St.1, St.2: Stepper; Molex_KK-254_AE-6410-04A_1x04_P2.54mm_Vertical
U1: ATmega168PA-AU; TQFP-32_7x7mm_P0.8mm
U2, U4, U5: DRV8811; HTSSOP-28-1EP_4.4x9.7mm_P0.65mm_EP2.85x5.4mm_ThermalVias
U3: ULN2003; SO-16_3.9x9.9mm_P1.27mm
Y1: Crystal; Crystal_SMD_HC49-SD

Connections:
+5V: C5.1, C11.1, C14.1, C16.1, C29.1, I2C.1, ISP.2, R2.1, R5.1, R10.1, R13.1, R26.1, R28.1, R30.1, R33.1, U1.4, U1.6, U1.18, U2.10, U2.27, U4.10, U4.27, U5.10, U5.27
+12V: C13.1, C15.1, C17.1, C18.1, C19.1, J3.1, Pump 0.2, Pump 1.2, Pump 2.2, R27.1, U2.15, U2.28, U3.9, U4.15, U4.28, U5.15, U5.28
/DIR0: U1.23, U2.3
/DIR1: U1.24, U4.3
/DIR2: U1.25, U5.3
/HOME0: Home 0.2, U1.2
/HOME1: Home 1.2, U1.10
/HOME2: Home 2.2, U1.11
/I2C_SCL: I2C.3, U1.28
/I2C_SDA: I2C.2, U1.27
/PUMP0: U1.12, U3.1, U3.2
/PUMP1: U1.13, U3.3, U3.4
/PUMP2: U1.26, U3.5, U3.6, U3.7
/RST: ISP.5, R28.2, RESET.2, U1.29, U2.17, U4.17, U5.17
/SPI_MISO: ISP.1, U1.16
/SPI_MOSI: ISP.4, U1.15
/SPI_SCK: ISP.3, U1.17
/STATUS: R25.1, U1.32
/STEP0: U1.9, U2.19
/STEP1: U1.14, U4.19
/STEP2: U1.1, U5.19
/XTAL1: C20.1, U1.7, Y1.1
/XTAL2: C24.1, U1.8, Y1.2
GND: 5V.1, 12V.1, C1.2, C2.2, C3.2, C6.1, C7.2, C8.2, C9.2, C12.1, C13.2, C14.2, C15.2, C16.2, C17.2, C18.2, C19.2, C20.2, C24.2, C25.2, C26.2, C27.2, C30.1, Home 0.1, Home 1.1, Home 2.1, I2C.4, ISP.6, J3.2, R1.2, R3.2, R4.2, R6.2, R7.2, R8.2, R9.2, R11.2, R12.2, R14.2, R15.2, R16.2, R29.2, R31.2, R32.2, R34.2, R35.2, R36.2, RESET.1, ST.1, U1.3, U1.5, U1.21, U2.7, U2.12, U2.13, U2.16, U2.21, U2.26, U2.29, U3.8, U4.7, U4.12, U4.13, U4.16, U4.21, U4.26, U4.29, U5.7, U5.12, U5.13, U5.16, U5.21, U5.26, U5.29
unnamed: C1.1, R2.2, R3.1, U4.5
unnamed: C2.1, R1.1, U4.6
unnamed: C3.1, R4.1, U4.9
unnamed: C4.1, U4.23
unnamed: C4.2, U4.24
unnamed: C5.2, U4.22
unnamed: C6.2, U4.20
unnamed: C7.1, R10.2, R11.1, U5.5
unnamed: C8.1, R9.1, U5.6
unnamed: C9.1, R12.1, U5.9
unnamed: C10.1, U5.23
unnamed: C10.2, U5.24
unnamed: C11.2, U5.22
unnamed: C12.2, U5.20
unnamed: C25.1, R30.2, R31.1, U2.5
unnamed: C26.1, R29.1, U2.6
unnamed: C27.1, R32.1, U2.9
unnamed: C28.1, U2.23
unnamed: C28.2, U2.24
unnamed: C29.2, U2.22
unnamed: C30.2, U2.20
unnamed: R25.2, ST.2
unnamed: 5V.2, R26.2
unnamed: 12V.2, R27.2
unnamed: St.1.1, U4.18
unnamed: St.1.2, U4.11
unnamed: St.1.3, U4.25
unnamed: St.1.4, U4.4
unnamed: St.2.1, U5.18
unnamed: St.2.2, U5.11
unnamed: St.2.3, U5.25
unnamed: St.2.4, U5.4
unnamed: Pump 0.1, U3.15, U3.16
unnamed: Pump 1.1, U3.13, U3.14
unnamed: Pump 2.1, U3.10, U3.11, U3.12
unnamed: St.0.1, U2.18
unnamed: St.0.2, U2.11
unnamed: St.0.3, U2.25
unnamed: St.0.4, U2.4
unnamed: R5.2, R6.1, U4.8
unnamed: R7.1, U4.1
unnamed: R8.1, U4.14
unnamed: R13.2, R14.1, U5.8
unnamed: R15.1, U5.1
unnamed: R16.1, U5.14
unnamed: R33.2, R34.1, U2.8
unnamed: R35.1, U2.1
unnamed: R36.1, U2.14
