felixzero/escrocs/CAD/electrical/accessory_board/accessory_board.kicad_pcb

## KiCad design CAD/electrical/accessory_board/accessory_board.kicad_pcb (2021-10-03)

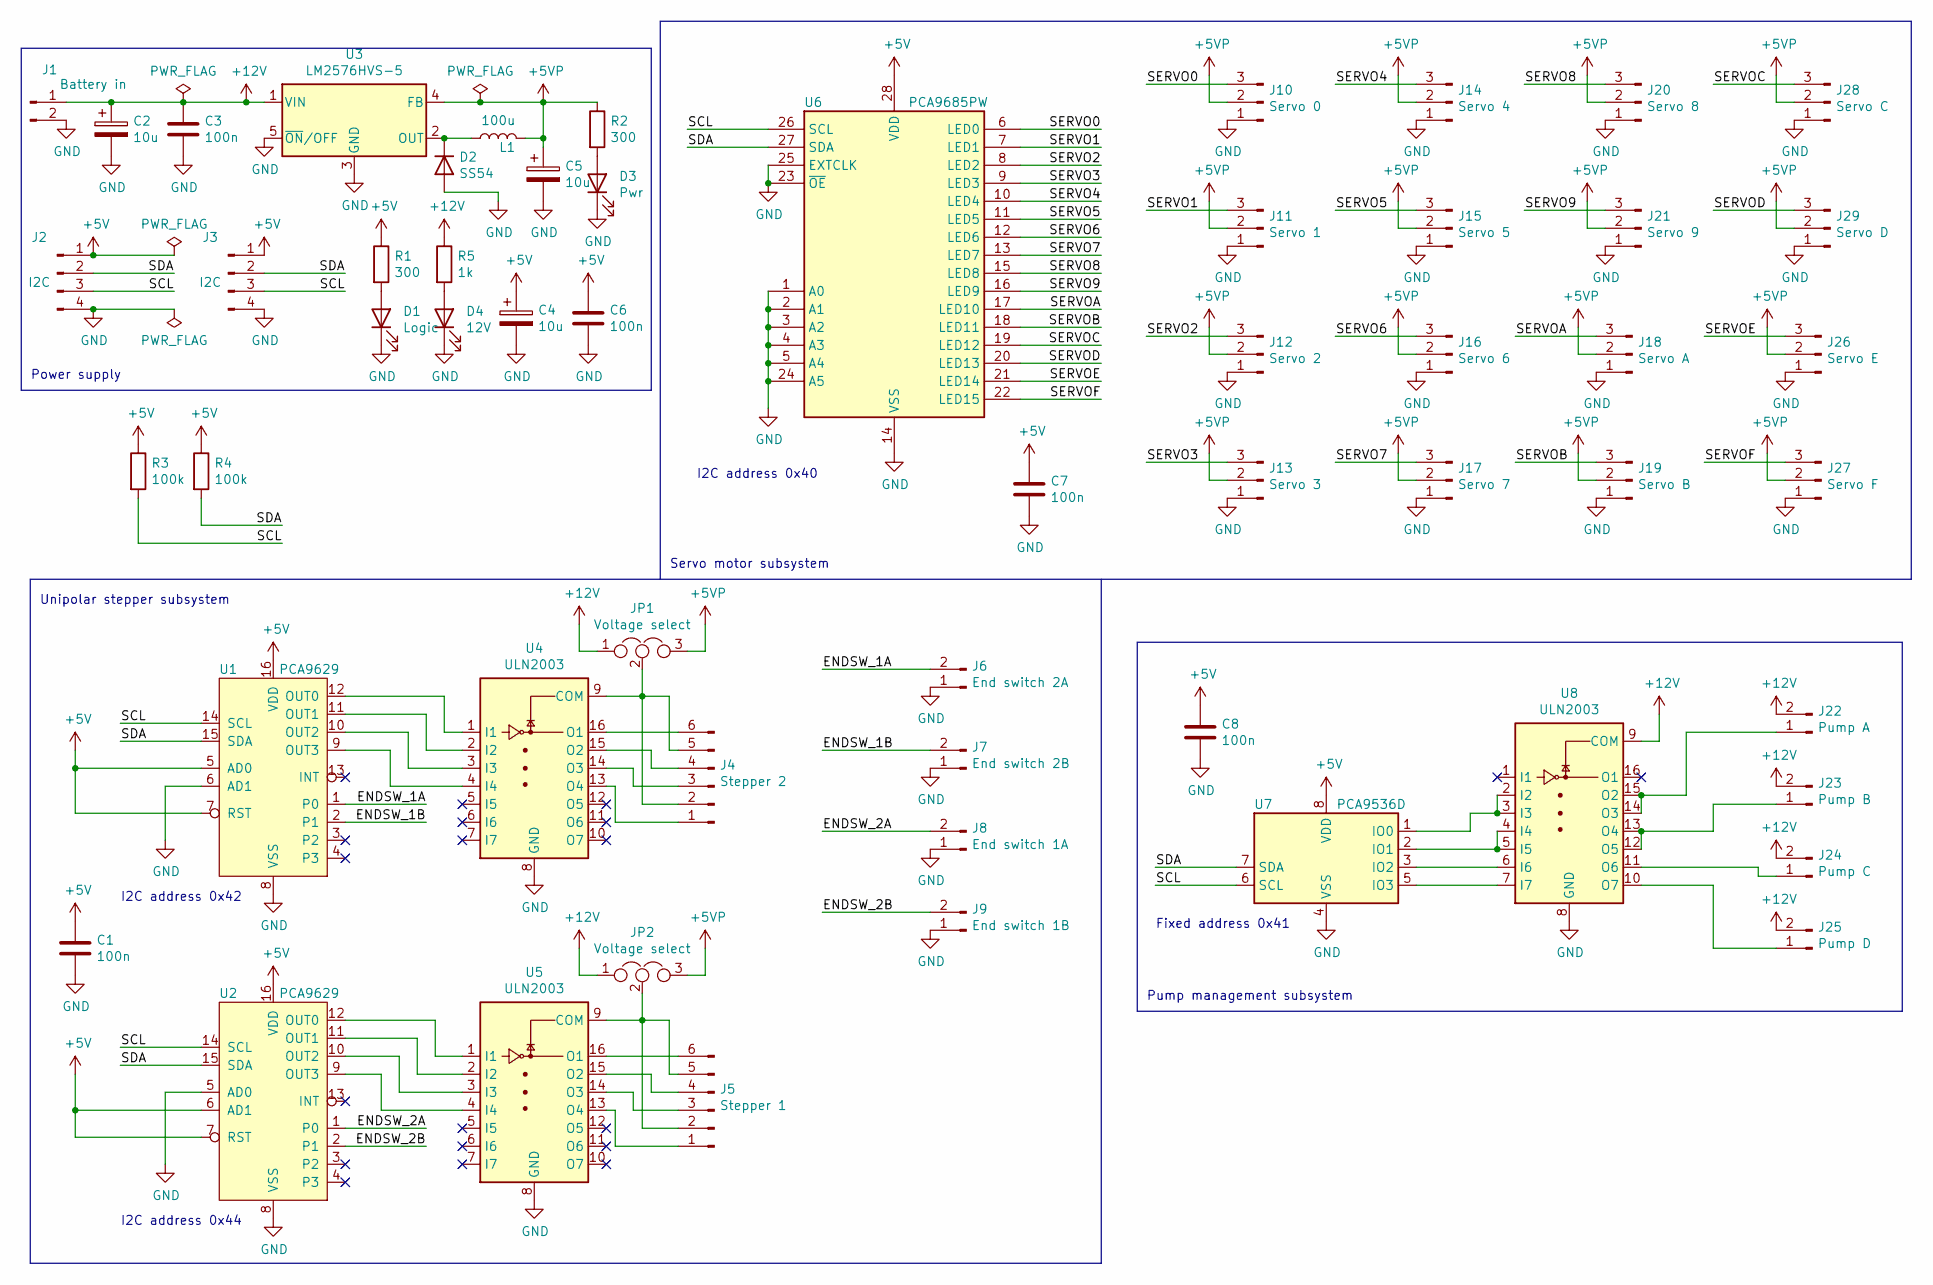
[picture p58: schematic accessory_board.kicad_sch]

Parts:
C1, C3, C6, C7, C8: 100n; C_1206_3216Metric_Pad1.33x1.80mm_HandSolder
C2, C4, C5: 10u; CP_Radial_D5.0mm_P2.00mm
D1: Logic; LED_D3.0mm
D2: SS54; D_SMB_Handsoldering
D3: Pwr; LED_D3.0mm
D4: 12V; LED_D3.0mm
J1: Battery in; BarrelJack_Horizontal
J2, J3: I2C; Molex_KK-254_AE-6410-04A_1x04_P2.54mm_Vertical
J4: Stepper 2; Molex_KK-254_AE-6410-06A_1x06_P2.54mm_Vertical
J5: Stepper 1; Molex_KK-254_AE-6410-06A_1x06_P2.54mm_Vertical
J6: End switch 2A; Molex_KK-254_AE-6410-02A_1x02_P2.54mm_Vertical
J7: End switch 2B; Molex_KK-254_AE-6410-02A_1x02_P2.54mm_Vertical
J8: End switch 1A; Molex_KK-254_AE-6410-02A_1x02_P2.54mm_Vertical
J9: End switch 1B; Molex_KK-254_AE-6410-02A_1x02_P2.54mm_Vertical
J10: Servo 0; Molex_KK-254_AE-6410-03A_1x03_P2.54mm_Vertical
J11: Servo 1; Molex_KK-254_AE-6410-03A_1x03_P2.54mm_Vertical
J12: Servo 2; Molex_KK-254_AE-6410-03A_1x03_P2.54mm_Vertical
J13: Servo 3; Molex_KK-254_AE-6410-03A_1x03_P2.54mm_Vertical
J14: Servo 4; Molex_KK-254_AE-6410-03A_1x03_P2.54mm_Vertical
J15: Servo 5; Molex_KK-254_AE-6410-03A_1x03_P2.54mm_Vertical
J16: Servo 6; Molex_KK-254_AE-6410-03A_1x03_P2.54mm_Vertical
J17: Servo 7; Molex_KK-254_AE-6410-03A_1x03_P2.54mm_Vertical
J18: Servo A; Molex_KK-254_AE-6410-03A_1x03_P2.54mm_Vertical
J19: Servo B; Molex_KK-254_AE-6410-03A_1x03_P2.54mm_Vertical
J20: Servo 8; Molex_KK-254_AE-6410-03A_1x03_P2.54mm_Vertical
J21: Servo 9; Molex_KK-254_AE-6410-03A_1x03_P2.54mm_Vertical
J22: Pump A; Molex_KK-254_AE-6410-02A_1x02_P2.54mm_Vertical
J23: Pump B; Molex_KK-254_AE-6410-02A_1x02_P2.54mm_Vertical
J24: Pump C; Molex_KK-254_AE-6410-02A_1x02_P2.54mm_Vertical
J25: Pump D; Molex_KK-254_AE-6410-02A_1x02_P2.54mm_Vertical
J26: Servo E; Molex_KK-254_AE-6410-03A_1x03_P2.54mm_Vertical
J27: Servo F; Molex_KK-254_AE-6410-03A_1x03_P2.54mm_Vertical
J28: Servo C; Molex_KK-254_AE-6410-03A_1x03_P2.54mm_Vertical
J29: Servo D; Molex_KK-254_AE-6410-03A_1x03_P2.54mm_Vertical
JP1, JP2: Voltage select; PinHeader_1x03_P2.54mm_Vertical
L1: 100u; L_Radial_D24.4mm_P23.70mm_muRATA_1400series
R1, R2: 300; R_1206_3216Metric_Pad1.30x1.75mm_HandSolder
R3, R4: 100k; R_1206_3216Metric_Pad1.30x1.75mm_HandSolder
R5: 1k; R_1206_3216Metric_Pad1.30x1.75mm_HandSolder
U1, U2: PCA9629; TSSOP-16_4.4x5mm_P0.65mm
U3: LM2576HVS-5; TO-263-5_TabPin3
U4, U5, U8: ULN2003; SO-16_3.9x9.9mm_P1.27mm
U6: PCA9685PW; TSSOP-28_4.4x9.7mm_P0.65mm
U7: PCA9536D; SOIC-8_3.9x4.9mm_P1.27mm

Connections:
+5V: C1.1, C4.1, C6.1, C7.1, C8.1, J2.1, J3.1, R1.1, R3.1, R4.1, U1.5 (AD0), U1.7 (RST), U1.16 (VDD), U2.6 (AD1), U2.7 (RST), U2.16 (VDD), U6.28 (VDD), U7.8 (VDD)
+5VP: C5.1, J10.2, J11.2, J12.2, J13.2, J14.2, J15.2, J16.2, J17.2, J18.2, J19.2, J20.2, J21.2, J26.2, J27.2, J28.2, J29.2, JP1.3, JP2.3, L1.2, R2.1, U3.4 (FB)
+12V: C2.1, C3.1, J1.1, J22.2, J23.2, J24.2, J25.2, JP1.1, JP2.1, R5.1, U3.1 (VIN), U8.9 (COM)
/ENDSW_1A: J6.2, U1.1 (P0)
/ENDSW_1B: J7.2, U1.2 (P1)
/ENDSW_2A: J8.2, U2.1 (P0)
/ENDSW_2B: J9.2, U2.2 (P1)
/SCL: J2.3, J3.3, R3.2, U1.14 (SCL), U2.14 (SCL), U6.26 (SCL), U7.6 (SCL)
/SDA: J2.2, J3.2, R4.2, U1.15 (SDA), U2.15 (SDA), U6.27 (SDA), U7.7 (SDA)
/SERVO0: J10.3, U6.6 (LED0)
/SERVO1: J11.3, U6.7 (LED1)
/SERVO2: J12.3, U6.8 (LED2)
/SERVO3: J13.3, U6.9 (LED3)
/SERVO4: J14.3, U6.10 (LED4)
/SERVO5: J15.3, U6.11 (LED5)
/SERVO6: J16.3, U6.12 (LED6)
/SERVO7: J17.3, U6.13 (LED7)
/SERVO8: J20.3, U6.15 (LED8)
/SERVO9: J21.3, U6.16 (LED9)
/SERVOA: J18.3, U6.17 (LED10)
/SERVOB: J19.3, U6.18 (LED11)
/SERVOC: J28.3, U6.19 (LED12)
/SERVOD: J29.3, U6.20 (LED13)
/SERVOE: J26.3, U6.21 (LED14)
/SERVOF: J27.3, U6.22 (LED15)
GND: C1.2, C2.2, C3.2, C4.2, C5.2, C6.2, C7.2, C8.2, D1.1 (K), D2.2 (A), D3.1 (K), D4.1 (K), J1.2, J2.4, J3.4, J6.1, J7.1, J8.1, J9.1, J10.1, J11.1, J12.1, J13.1, J14.1, J15.1, J16.1, J17.1, J18.1, J19.1, J20.1, J21.1, J26.1, J27.1, J28.1, J29.1, U1.6 (AD1), U1.8 (VSS), U2.5 (AD0), U2.8 (VSS), U3.3 (GND), U3.5 (~ON/OFF), U4.8 (GND), U5.8 (GND), U6.1 (A0), U6.2 (A1), U6.3 (A2), U6.4 (A3), U6.5 (A4), U6.14 (VSS), U6.23 (~OE), U6.24 (A5), U6.25 (EXTCLK), U7.4 (VSS), U8.8 (GND)
unnamed: D1.2 (A), R1.2
unnamed: D2.1 (K), L1.1, U3.2 (OUT)
unnamed: D3.2 (A), R2.2
unnamed: D4.2 (A), R5.2
unnamed: J4.1, U4.13 (O4)
unnamed: J4.2, J4.5, JP1.2, U4.9 (COM)
unnamed: J4.3, U4.14 (O3)
unnamed: J4.4, U4.15 (O2)
unnamed: J4.6, U4.16 (O1)
unnamed: J5.1, U5.13 (O4)
unnamed: J5.2, J5.5, JP2.2, U5.9 (COM)
unnamed: J5.3, U5.14 (O3)
unnamed: J5.4, U5.15 (O2)
unnamed: J5.6, U5.16 (O1)
unnamed: J22.1, U8.14 (O3), U8.15 (O2)
unnamed: J23.1, U8.12 (O5), U8.13 (O4)
unnamed: J24.1, U8.11 (O6)
unnamed: J25.1, U8.10 (O7)
unnamed: U1.9 (OUT3), U4.4 (I4)
unnamed: U1.10 (OUT2), U4.3 (I3)
unnamed: U1.11 (OUT1), U4.2 (I2)
unnamed: U1.12 (OUT0), U4.1 (I1)
unnamed: U2.9 (OUT3), U5.4 (I4)
unnamed: U2.10 (OUT2), U5.3 (I3)
unnamed: U2.11 (OUT1), U5.2 (I2)
unnamed: U2.12 (OUT0), U5.1 (I1)
unnamed: U7.1 (IO0), U8.2 (I2), U8.3 (I3)
unnamed: U7.2 (IO1), U8.4 (I4), U8.5 (I5)
unnamed: U7.3 (IO2), U8.6 (I6)
unnamed: U7.5 (IO3), U8.7 (I7)

Notes on the sheet:
Fixed address 0x41
I2C address 0x42
I2C address 0x40
I2C address 0x44
Pump management subsystem
Power supply
Servo motor subsystem
Unipolar stepper subsystem

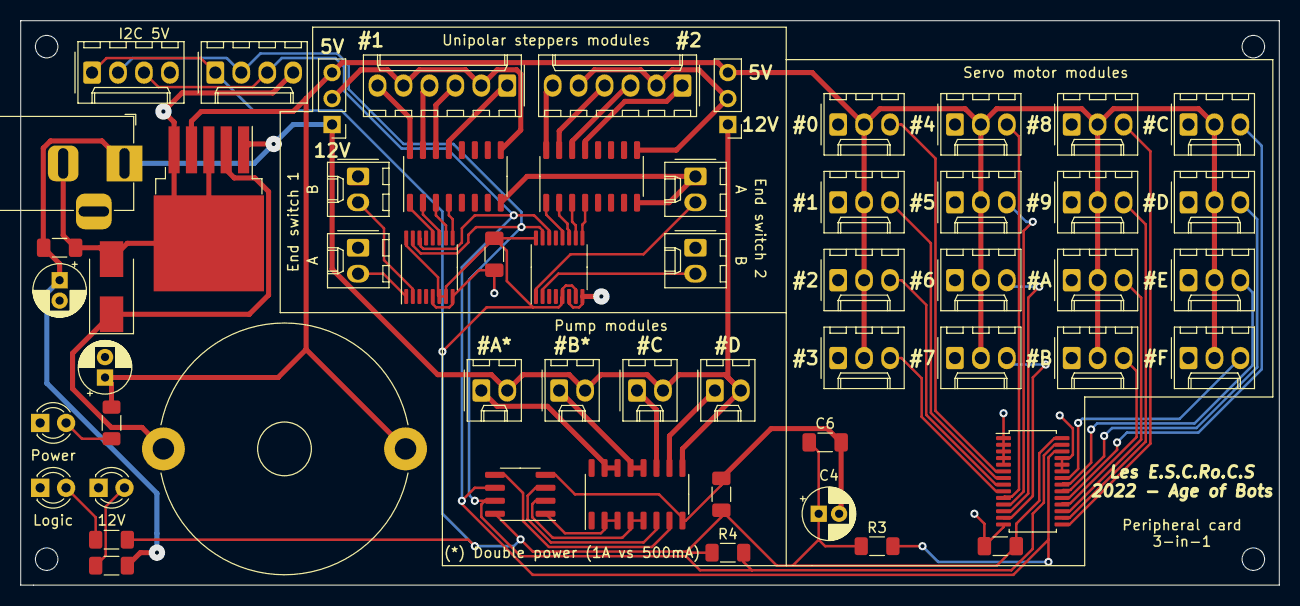
[picture p59: board accessory_board.kicad_pcb from above]

Board: 2 copper layers, 123.2 x 55.2 mm, 57 parts (0 on the bottom side), 56 nets.
