felixzero/escrocs/code/main_board/src/peripherals/motor_board_v3.c

#include "motor_board_v3.h"
#include "../system/modbus_rtu_master.h"

#include <esp_log.h>
#include <math.h>
#include <string.h>

#define MOTOR_BOARD_MODBUS_ADDR     0x44
#define MOTOR_BOARD_I2C_ADDR        0x11

#define MOTOR_BOARD_SPEED_REG       10000
#define MOTOR_BOARD_ENCODER_REG     10100
#define MOTOR_BOARD_ENABLE_COIL     20000

#define TICK_PER_TURN               (32 * 400.0)
#define MAX_ID_LEN                  64
#define TAG                         "Motor board v3"

#define CLAMP_ABS(x, clamp) ((fabsf(x) > (clamp)) ? (clamp) * (x) / fabsf(x) : (x))

static int16_t previous_encoder_raw_values[3];

esp_err_t init_motor_board_v3(void)
{
    esp_err_t err = disable_motors();
    ESP_ERROR_CHECK_WITHOUT_ABORT(err);
    return ESP_OK;
}

esp_err_t read_encoder_increment(encoder_measurement_t *measurement)
{
    int16_t encoder_raw_values[3];
    esp_err_t err = modbus_read_holding_registers(MOTOR_BOARD_MODBUS_ADDR, MOTOR_BOARD_ENCODER_REG, 3, (uint16_t*)encoder_raw_values);
    if (err) {
        measurement->channel1 = 0;
        measurement->channel2 = 0;
        measurement->channel3 = 0;
        ESP_ERROR_CHECK_WITHOUT_ABORT(err);
        return err;
    }

    measurement->channel1 = (float)((int16_t)(encoder_raw_values[0] - previous_encoder_raw_values[0])) / TICK_PER_TURN;
    measurement->channel2 = (float)((int16_t)(encoder_raw_values[1] - previous_encoder_raw_values[1])) / TICK_PER_TURN;
    measurement->channel3 = (float)((int16_t)(encoder_raw_values[2] - previous_encoder_raw_values[2])) / TICK_PER_TURN;

    memcpy(previous_encoder_raw_values, encoder_raw_values, 3 * sizeof(int16_t));

    return ESP_OK;
}

esp_err_t write_motor_speed_raw(float speed1, float speed2, float speed3)
{
    int16_t raw_values[3];
    raw_values[0] = INT16_MAX * CLAMP_ABS(speed1, 1.0);
    raw_values[1] = INT16_MAX * CLAMP_ABS(speed2, 1.0);
    raw_values[2] = INT16_MAX * CLAMP_ABS(speed3, 1.0);

    esp_err_t err = modbus_preset_multiple_registers(MOTOR_BOARD_MODBUS_ADDR, MOTOR_BOARD_SPEED_REG, 3, (uint16_t*)raw_values);
    ESP_ERROR_CHECK_WITHOUT_ABORT(err);

    return err;
}

esp_err_t write_motor_speed_rad_s(float speed1, float speed2, float speed3)
{
    const float MAX_SPEED_RPM = 300;
    const float MAX_SPEED_RAD_S = MAX_SPEED_RPM / 60 * 2 * M_PI;

    return write_motor_speed_raw(speed1 / MAX_SPEED_RAD_S, speed2 / MAX_SPEED_RAD_S, speed3 / MAX_SPEED_RAD_S);
}

esp_err_t enable_motors(void)
{
    esp_err_t err = modbus_force_single_coil(MOTOR_BOARD_MODBUS_ADDR, MOTOR_BOARD_ENABLE_COIL, true);
    ESP_ERROR_CHECK_WITHOUT_ABORT(err);

    return err;
}

esp_err_t disable_motors(void)
{
    esp_err_t err = modbus_force_single_coil(MOTOR_BOARD_MODBUS_ADDR, MOTOR_BOARD_ENABLE_COIL, false);
    ESP_ERROR_CHECK_WITHOUT_ABORT(err);

    return err;
}

bool are_motors_enabled(void)
{
    bool output;
    ESP_ERROR_CHECK_WITHOUT_ABORT(modbus_read_coil_status(MOTOR_BOARD_MODBUS_ADDR, MOTOR_BOARD_ENABLE_COIL, 1, &output));
    return output;
}
