felixzero/escrocs/code/main_board/src/controllers/motion_control.h

#pragma once

#include <stdbool.h>
#include <sdkconfig.h>
#include <esp_err.h>

#define MOTION_STEP_DONE                0
#define MOTION_STEP_RUNNING             1

#define MOTION_PERIOD_MS                10


/**
 * Pose of the robot
 * @param x (and y) position in mm
 * @param theta angle in degree
 * NaN values signify no change (for x and y) and don't care (for theta)
 */
typedef struct {
    float x;
    float y;
    float theta;
} pose_t;

typedef struct {
    pose_t pose;
    bool perform_detection;
    int motion_step;
    bool is_blocked;
} motion_status_t;

/**
 * Init motion control subsystem
 */
esp_err_t init_motion_control(bool reversed_side);

/**
 * Set a (x, y, theta) target in (mm, mm, deg)
 */
void set_motion_target(const pose_t *target, bool perform_detection);

/**
 * Get current (x, y, theta) pose in (mm, mm, deg)
 */
pose_t get_current_pose(void);

/**
 * Declare current pose as equal to a known value
 * Used to (re-)initialize the motion control system
 */
void overwrite_current_pose(const pose_t *target);

/**
 * Stop all motion
 */
void stop_motion(void);

/**
 * Check if the robot is still in motion
 */
bool is_motion_done(void);

/**
 * Check if the robot is stopped due to an obstacle
 */
bool is_blocked(void);

void enable_motors_and_set_timer(void);
