felixzero/escrocs/code/motor_board_v3/src/com_registers.h

#pragma once

#include <stdint.h>
#include <stdbool.h>

#include "com_registers_def.h"

#define RS485_BAUD_RATE         500000

#define MODBUS_SLAVE_ADDR       0x44

#define COM_REG_MOTOR_SPEED_0   10000
#define COM_REG_MOTOR_SPEED_1   10001
#define COM_REG_MOTOR_SPEED_2   10002

#define COM_REG_MOTOR_STEPS_0   10100
#define COM_REG_MOTOR_STEPS_1   10101
#define COM_REG_MOTOR_STEPS_2   10102

#define COM_COIL_ENABLE_MOTORS  20000
