felixzero/escrocs/(commit log)

2019-10-27 Initial code for Arduino.
2019-12-01 Sensors & Actuators
    Code de test unitaires des sous-systèmes:
    - Module Sonar HC-SR04 x2
    - Micro Servo Tower 9g
2020-01-24 Add CAD design files to git.
    [arret-urgence.FCStd, barre-transversale.FCStd, carte-alim.kicad_pcb, carte-alim.sch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]
2020-01-29 Add mast and top plate designs.
    [pied-mat.FCStd, support-balise.FCStd]
2020-01-30 Add code for magnetometer.
2020-01-31 Add CAD design for antenna.
    [robot-antenna.kicad_pcb, robot-antenna.sch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]
2020-02-06 Add flag, top plate design and move Servo to its own folder.
    [top-plate.FCStd]
2020-02-18 Add several cards & parts.
    [cup-fork.FCStd, flipper.FCStd, servo.kicad_pcb, servo.sch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]
2020-02-20 Add servo board code (not tested yet).
2020-02-20 Reformat code into a C++ object interface. Make servo module work.
2020-02-21 Fix servo board code.
2020-02-21 Add servo board CAD design.
    [servo.kicad_pcb, servo.sch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]
2020-02-23 Add some mechanical parts.
    [arm-braket.FCStd, windsock-triggerer.FCStd]
2020-03-12 Make servo board work fine.
2020-03-14 Fix servo code
2020-10-14 Add ecueil
    [rainurage-gobelet.FCStd]
2020-10-27 Ready for the cup!?
    [windsock-arm-last-minute.FCStd]
2020-11-02 Nouveau design de carte servo
    [servo.kicad_pcb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]
2020-11-02 Remove antenna board (useless)
    [robot-antenna.kicad_pcb, robot-antenna.sch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]
2020-11-02 New power supply card and lighthouse card
    [carte-alim.kicad_pcb, carte-alim.sch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]
2020-11-12 Electronics sent to manufacturer
    [carte-radio.kicad_pcb, carte-radio.sch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]
2020-11-12 First version of trigger
    [trigger.FCStd]
2020-11-17 CNC files for trigger
    [trigger.FCStd]
2020-11-22 Add score board and LCD control code
    [score-plate.FCStd]
2021-01-02 Ajoute la pince à gobelets
    [arm-braket.FCStd, bras-pince.FCStd, bras-pince.obj, fixation-profile.FCStd, fixation-profile.obj, pince-gear.obj, pince-mobile.obj, pince-support.obj]
2021-01-08 Add motor control board design
    [motor-control.kicad_pcb, motor-control.sch]
2021-01-08 Add prototype patin
    [patin.FCStd]
2021-01-08 Lower wheel
    [support-moteur-v2.FCStd]
2021-03-05 pince, carte elec moteur, code carte moteur
    [motor-control-B_Cu.gbr, motor-control-B_Mask.gbr, motor-control-B_SilkS.gbr, motor-control-Edge_Cuts.gbr, motor-control-F_Cu.gbr, motor-control-F_Mask.gbr, motor-control-F_SilkS.gbr, motor-control.drl]
2021-06-06 CAD - Sonar holders
    [HC-SR04-holder.stl, Sonar_box_baseplate.stl, Sonar_box_support.stl, Sonar_box_upperplate.stl, Sonar_mast-baseplate.stl, Sonar_mast-cover.stl, T-Junction.stl, T-SlotAngle-Brackets-M3.stl]
2021-06-20 Ajout du code de gestion de l'I2C sur la carte moteur esclave
2021-06-20 Ajout du déclencheur
    [cle.obj, devant.obj, fond.obj, support-moteur-long.FCStd, support-moteur-long.obj]
2021-06-30 Ajout du mat de détection
    [detection.FCStd, detection.obj, toit.obj]
2021-07-03 Cache pour mat sonar robot2
    [Sonar_mast_round_cache.stl]
2021-07-04 Updated pinout with triple sonar pins
2021-07-07 Augmentation de la vitesse
    [lighthouse.FCStd, lighthouse.obj, lighthouse2.obj, patin-Body.obj, patin.FCStd, pousse-phare-Axe 2.obj, pousse-phare-Coin.obj, pousse-phare-Support profilé.obj]
2021-07-09 Omnibot 2021 - Homologué
    Code de la carte "moteur" du robot 2 (CdFR 2021)
2021-07-09 Omnibot US module
    Tentatives de faire fonctionner le mât ultrason
2021-07-31 Added new US Detection module
    First commit - code still WIP
    6 US modules piloted by Arduino Nano
    Feedback via WS2812B LED ring
    Controlled via I2C
    Several modes:
    - Startup: US module check up
    - Detection: color gradient depending on measured distance for each module
    - Error: Flash
    - Wait: During game setup, display current side color
    - Endgame: Color animation after game ends
    [ultrasound.h]
2021-09-03 ArUCo detection byRaspberry pi
    Detects wind orientation (NORTH/SOUTH) and outputs a signal on raspberry's GPIO if SOUTH.
2021-09-04 Wind info detector
    Basic tri-state reader for getting wind orientation from raspberry layer.
    Basic implementation: Uses two digital input pins.
2021-09-07 Add code for motor board of secondary robot
    [base_roulante-CaleProfile.obj, base_roulante-EquerreCarteMoteur.obj, base_roulante-RenfortBas.obj, base_roulante-SupportCarteMoteur.obj, base_roulante-SupportMoteur.obj, base_roulante-TriangleBatterie.obj, base_roulante.FCStd, holobot.kicad_pcb]
2021-09-08 Motor PWM control with double buffering
2021-09-11 Add schematics for hacked main board and add I2C to motor board
    [holobot_esp32-B_Cu.gbr, holobot_esp32-B_Mask.gbr, holobot_esp32-B_Paste.gbr, holobot_esp32-B_SilkS.gbr, holobot_esp32-Edge_Cuts.gbr, holobot_esp32-F_Cu.gbr, holobot_esp32-F_Mask.gbr, holobot_esp32-F_Paste.gbr]
2021-09-12 Add north/south detection and I2C control of motor board
2021-10-03 Add OTA and Wifi to main board
2021-10-03 Add CAD for main and accessory boards
    [accessory_board-B_Cu.gbr, accessory_board-B_Mask.gbr, accessory_board-B_Paste.gbr, accessory_board-B_SilkS.gbr, accessory_board-Edge_Cuts.gbr, accessory_board-F_Cu.gbr, accessory_board-F_Mask.gbr, accessory_board-F_Paste.gbr]
2021-10-03 Configure ESP32 as AP
2021-10-16 Add gyroscope
2021-10-17 ArUco 2022
    ArUco tags for "Samples" game elements
    Basic python code with OpenCV for detection and color classification
2021-10-19 Main board v2
    [bom.xlsx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]
2021-10-28 Add main robot support
    [batterie_elec-Fond.amf, batterie_elec-PatteFixation.amf, batterie_elec-PlaqueDessus.amf, batterie_elec-PlaqueLaterale.amf, batterie_elec.FCStd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]
2021-11-01 First measurements from lidar board.
2021-11-15 Add lidar board and motor board v2
    [bom.xlsx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]
2021-11-15 Add basic motor control
2021-11-22 Sort everything out
    [accessory_board-B_Cu.gbr, accessory_board-B_Mask.gbr, accessory_board-B_Paste.gbr, accessory_board-B_SilkS.gbr, accessory_board-Edge_Cuts.gbr, accessory_board-F_Cu.gbr, accessory_board-F_Mask.gbr, accessory_board-F_Paste.gbr]
2022-01-13 Lidar board v2 and stepper board
    [adapter-B_Cu.gbr, adapter-B_Mask.gbr, adapter-B_Paste.gbr, adapter-B_SilkS.gbr, adapter-Edge_Cuts.gbr, adapter-F_Cu.gbr, adapter-F_Mask.gbr, adapter-F_Paste.gbr]
2022-01-13 Code for motor board v2 and stepper board
2022-01-13 Initial working code for lidar board
2022-02-14 Update code for lidar board
2022-02-14 CAD for secondary robot
    [base_roulante_v2-SupportCarteLidar.amf, base_roulante_v2-SupportCarteMere.amf, base_roulante_v2-SupportLidar.amf, base_roulante_v2-SupportPompe.amf, base_roulante_v2-TriangleBatterie.amf, base_roulante_v2.FCStd, rail_pompe-SupportGlissiere.amf, rail_pompe-SupportStepper.amf]
2022-02-24 Add lua strategy player
    [partition_table.csv]
2022-02-24 Update pump bracket
    [rail_pompe-SupportGlissiere.amf, rail_pompe.FCStd]
2022-02-24 Update fuse settings
2022-02-24 Add overwrite for steppers
2022-04-14 Fully working lidar board code
2022-04-14 Lidar capture utilities
    [capture.csv, capture_1.csv, capture_2.csv]
2022-05-09 Fix stepper board code
    [steppers.c]
2022-05-09 Add working lidar board communication
2022-05-09 Update mechanical CAD
    [Unnamed-Body.amf, base_roulante_v2-MatdeBalise.amf, base_roulante_v2.FCStd, bouton_cote-Body001.amf, bouton_cote.FCStd, rail_pompe-SupportGlissiereArticulee.amf, rail_pompe-SupportPompeArticulee.amf, rail_pompe.FCStd]
2022-05-09 Add mini accessory board
    [bom.xlsx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]
2022-05-09 Update motor board makefile
2022-05-09 Fix stepper board - main board communication
    [game_actions.c, game_actions.h, i2c_registers.c, i2c_registers.h, peripherals.c, peripherals.h, stepper_board.c, stepper_board.h]
2022-05-15 Add side change and fix holonomic robot
    [main.c, motion_control.h, motion_control_common.c]
2022-05-15 Steppers with active reset
    [main.c, steppers.c]
2022-05-15 Fix motion of robot 1
    [main.c, print_lidar_sse.py]
2022-05-18 Code Vitrine 2022 - trigger by contact switch, without US
2022-05-18 Add management of trigger and 100s timer
2022-05-18 Add mat de balise
    [base_roulante_v2-CoteAutocollant.amf, base_roulante_v2-SupportCarteServo.amf, base_roulante_v2.FCStd, mat_balise_robot_carre-MatdeBalise.amf, mat_balise_robot_carre.FCStd]
2022-05-19 Use wifi instead of I2C for lidar board
2022-05-19 Correct library for Servo + Neopixel use
2022-05-20 Python GUI for basic OTA control - Get, overwrite and set position (angle input is in degrees, converted to radians in the HTTP request) - Move steppers
2022-05-23 CAO statuette & pince
    [Robot_2022_broche-v2.stl, Robot_2022_broche.stl, Robot_2022_pince_support_Bas.stl, Robot_2022_pince_support_haut.stl, Robot_2022_pince_v2.stl, Robot_2022_support_broche.stl, Robot_2022_support_pince.stl, Robot_2022_support_pince_V.stl]
2022-05-23 Many importants fixes: - detection on robot triangle - lidar-main board communication - UDP logger - both strategies
    [actions_lua_functions.c, main.c, motion_control_common.c, print_lidar_sse.py, task_priority.h]
2022-05-23 Support carte lidar
    [Support_carte_lidar.stl]
2022-05-23 Fix some bugs to make the robots ready for the cup.
    [motion_control_common.c]
2022-05-30 Document and clean the PCB folder
    [accessory_board-B_Cu.gbr, accessory_board-B_Mask.gbr, accessory_board-B_Paste.gbr, accessory_board-B_SilkS.gbr, accessory_board-Edge_Cuts.gbr, accessory_board-F_Cu.gbr, accessory_board-F_Mask.gbr, accessory_board-F_Paste.gbr]
2022-05-30 Vitrine triggered by ultrasonic detection
2023-03-11 Add code for ultrasonic mast
2023-03-11 Add gun board
    [bldc_driver.kicad_sch, bom.xlsx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]
2023-03-11 Add CAD of ultrasonic board
    [bom.xls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]
2023-03-11 Misc stuff
    [robot_triangle.FCStd, support-us.FCStd]
2023-05-17 Update ESP32 firmware for new version
2023-05-17 Disable light display on ultrasonic mast
2023-05-17 Add ultrasonic detection on main board
2023-05-17 Fix I2C timeout issues on US board
    [controller.c, ultrasound.c, ultrasound.h]
2023-05-18 PyCommandOTA - Pump management
    Pump Over The Air
2023-05-22 All the missing stuff that was supposed to be commited before the cup
    [support-us-LED Support Pentagon.amf, support-us-PCBRing.amf, support-us-Support PCB Pentagon.amf, support-us-Toit.amf, support-us-US Ring Pentagon.amf, support-us-USRing.amf, support-us.FCStd, trigger-Clef.amf]
2023-06-20 Migrate electronic projects to Kicad 6
    [accessory_board.kicad_sch, adapter.kicad_pcb, adapter.sch, bldc_driver.kicad_sch, bom.xlsx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]
2023-06-20 Add new base roulante \o/
    [base_roulante_2024-Base.amf, base_roulante_2024-Carter base roulante.amf, base_roulante_2024-Common.amf, base_roulante_2024-Pare-choc.amf, base_roulante_2024-Plaque de base roulante.amf, base_roulante_2024.FCStd]
2023-06-20 Remove code of obsolete boards
2023-07-21 Updated version of motor board and main board (#3)
    * Cleaning backup files
    * [WIP] Main board V2
    * [WIP] Implement RS485 in ultrasonic board
    * Updated version of motor board and main board
    [bom.xlsx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]
2023-10-23 First version of code for motor board v3 (stepper) handling arbitrary ramps
2023-11-01 Code for stepper motor board (V3) with Modbus RTU/RS485 implementation
2023-11-04 Add Modbus capabilities between main board, motor board and ultrasonic board
2023-11-04 Update code for main board for stepper robot (not usable as is)
2023-11-17 Several bugfixes on main board
    [game_actions.c, holonomic_wheel_base.h, main.c, modbus_rtu_master.c, motion_control.c, motor_board_v3.c, motor_board_v3.h]
2023-11-19 Now with screen and menus and such
    [partition_table.csv]
2023-11-19 Kicad CAD for mainboard and motorboard (final)
    [bom.xlsx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]
2023-11-28 Fix integration of ultrasonic board
    [com_registers.h, controller.c, holonomic_wheel_base.c, holonomic_wheel_base.h, led_strip.c, main.c, modbus_rtu_master.c, modbus_rtu_slave.c]
2024-04-21 Lua functions improvements : Coroutines, US game_action support (#5)
    * Adding skeleton_coroutine in lua
    * table side sent to lua init, stupid line following lua
    * adding US_control, unworking stop while motion, untested strategy
    * Add US high level processing & working US_controller
    * Correcting issue, needing to set twice the pose to move after stop
    * stack overflow solve
    * overflow prevention
    * Quick cleanup
    * Cleanup of CAD files
    ---------
    [game_actions.c, game_actions.h, holonomic_wheel_base.c, holonomic_wheel_base.h, main.c, motion_control.c, motion_control.h]
2024-04-22 Fixing transform errors in rolling base
    [main.c, motion_control.c, motion_control.h]
2024-04-22 Fix issues with Lua strategy
    [main.c, strategy.c]
2024-05-02 Fix bug where robots makes random stuff. (#6)
    [modbus_rtu_master.c, motion_control.c, task_priority.h, us_control.c]
2024-05-02 Remove non compiling files and fix race condition in US controller (#7)
    [game_actions.c, game_actions.h, motion_control.c, us_control.c]
2024-05-04 Go back from RS485 to I2C
    * Remove non compiling files and fix race condition in US controller
    * Switch back from RS485 to I2C to robustify
    * Remove platformio change
    [controller.c, i2c_bus.c, i2c_bus.h, i2c_master.c, i2c_master.h, i2c_registers.c, i2c_registers.h, main.c]
2024-05-05 Make obstacle avoidance refuse obstacles outside of the terrain
    [holonomic_wheel_base.c, holonomic_wheel_base.h, us_control.c]
2024-05-05 Make obstacle avoidance refuse obstacles outside of the terrain (#11)
    [holonomic_wheel_base.c, holonomic_wheel_base.h, us_control.c]
2024-05-06 Lastminute (#13)
    * Make obstacle avoidance refuse obstacles outside of the terrain
    * Motor board back to RS485 (but with I2C on us)
    [i2c_master.c, main.c, modbus_rtu_master.c]
2024-05-12 Failed competition
    * Adjust parameters
    * Ceci plante mais est une base reglo
    * Set wifi enable/disable and upgrade ESP-IDF
    * This played the cup (poorly...)
    [actions_lua_functions.c, holonomic_wheel_base.c, holonomic_wheel_base.h, main.c, modbus_rtu_master.c, motion_control.c, steppers.c]
